aboavobr/ABOAVOBR/README.md

# ABOAVOBR - AutoBalancing Obstacle Avoiding Voice Obedient Beer Robot

| |Arduino|Raspberry Pi|App|
|:--:|:--:|:--:|:--:|
**Builds**|Build status (https://benjsawesometfstest.visualstudio.com/ABOAVOBR/_build/latest?definitionId=34)|Build status (https://benjsawesometfstest.visualstudio.com/ABOAVOBR/_build/latest?definitionId=35)|Build status (https://benjsawesometfstest.visualstudio.com/ABOAVOBR/_build/latest?definitionId=36)|
**Deployments**||||
**Release**||||

The intention of this project is to provide you with the necessary details to 3D print, assemble and program your own autobalancing robot with some quite advanced features.

## System Architecture
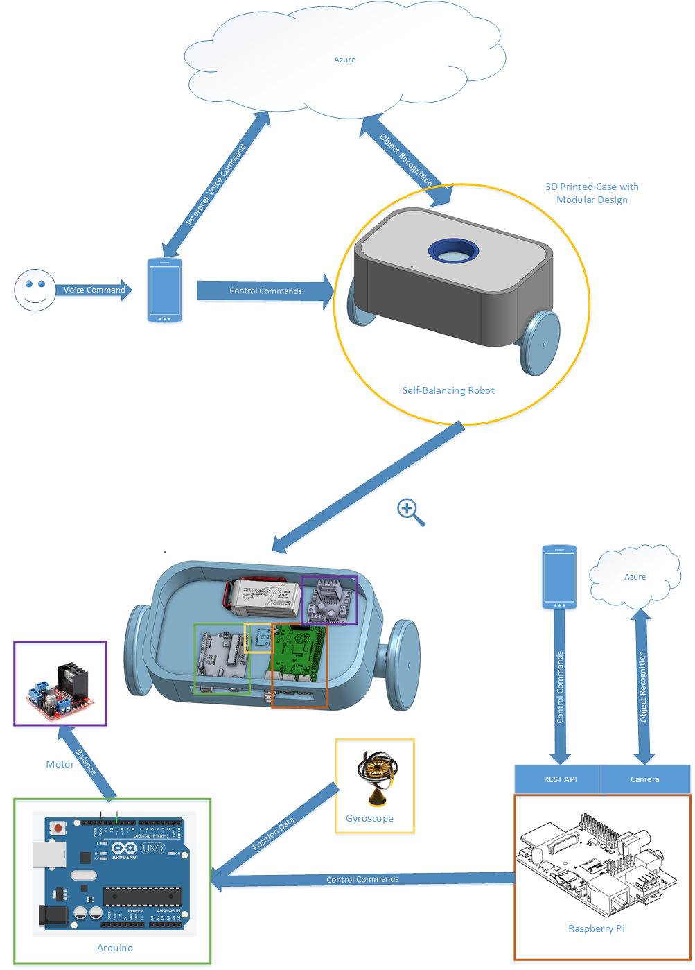
[picture p1: Documents/SystemDiagram.png]


## Bill of Materials
A detailed list with the materials needed including the 3D Model can be found [here](./Documents/BOM.md)

## Assembly instructions
TODO: Add 3d models and reference them here for printing.
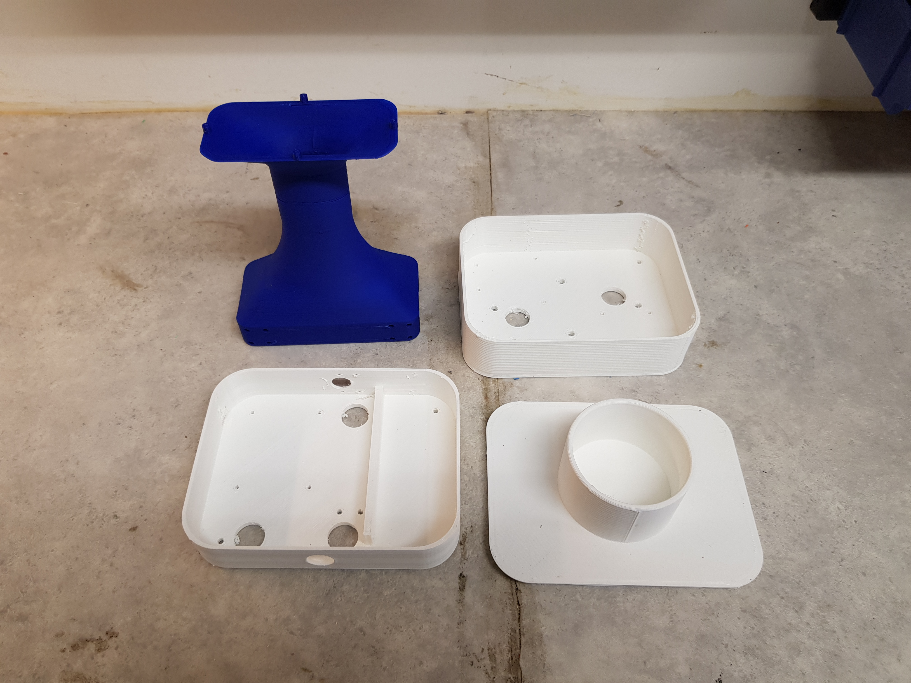
[picture p2: Construction/20190818_162025.jpg]


Fasten the motor mounts in the bottom part of the robot
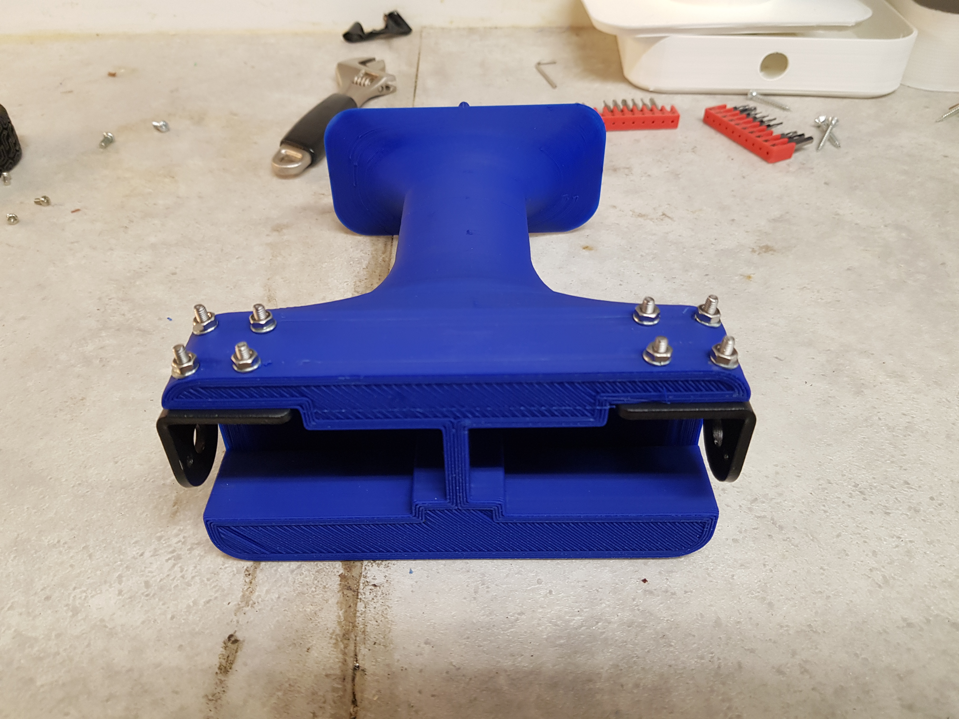
[picture p3: Construction/20190818_165857.jpg]


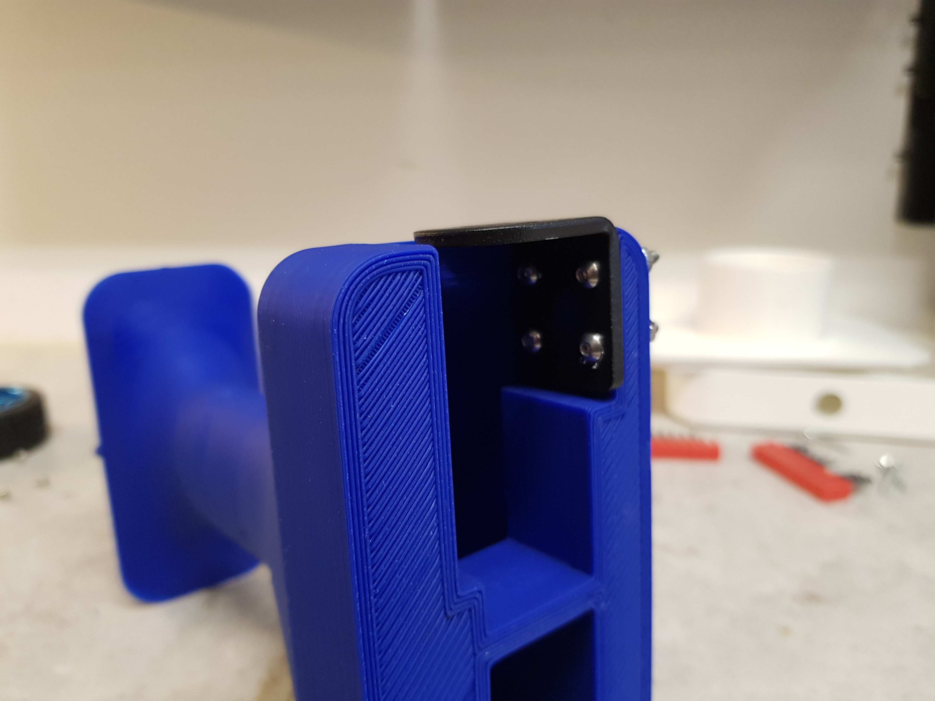
[picture p4: Construction/20190818_165904.jpg]


Lengthen the red and white wires (VCC, GND) coming out from the motors
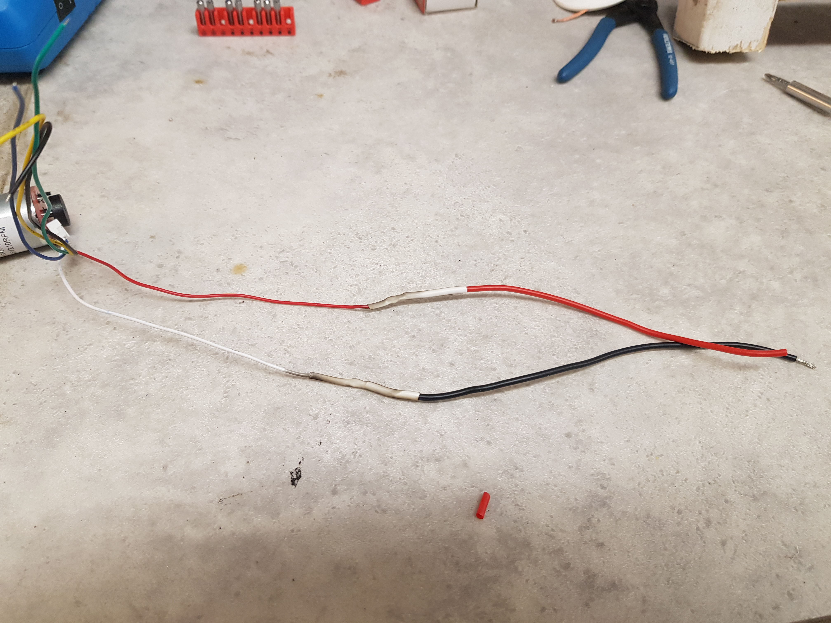
[picture p5: Construction/20190818_172829.jpg]


Mount the motors to the mounts
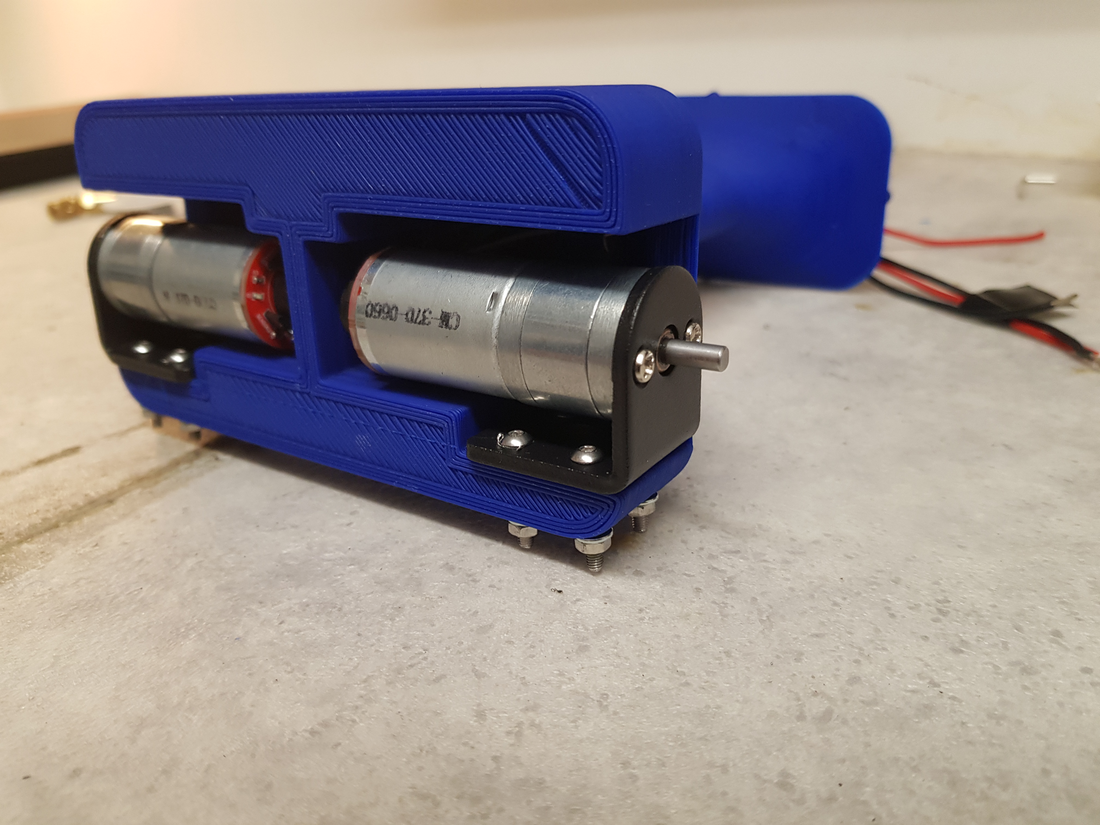
[picture p6: Construction/20190818_173135.jpg]


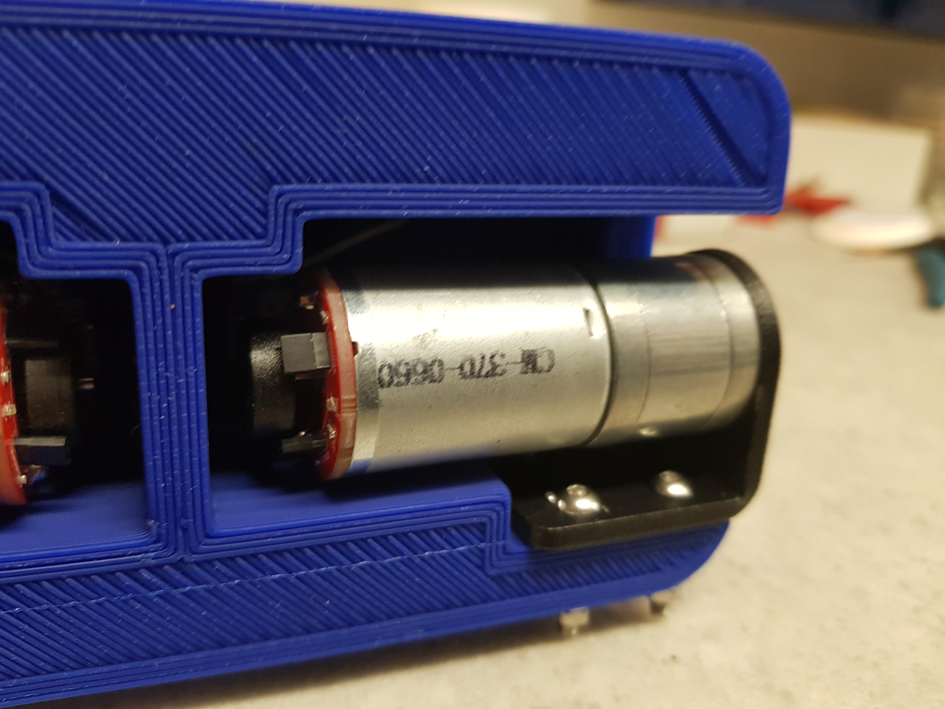
[picture p7: Construction/20190818_173138.jpg]


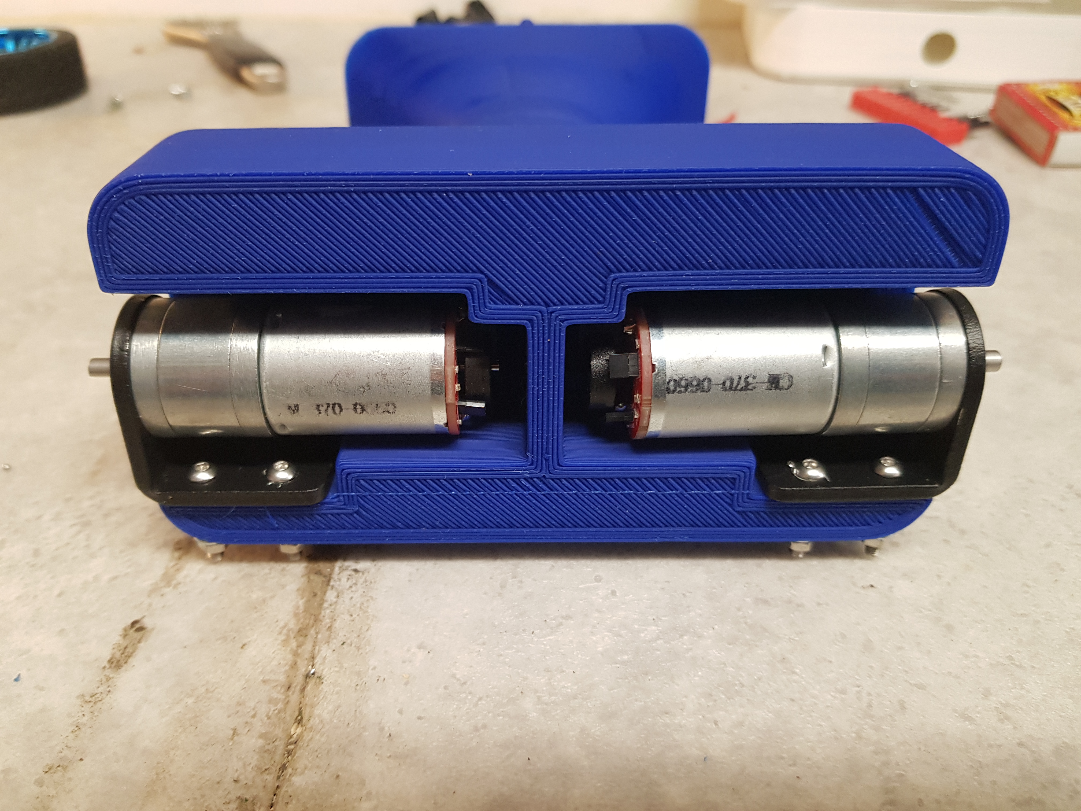
[picture p8: Construction/20190818_173141.jpg]


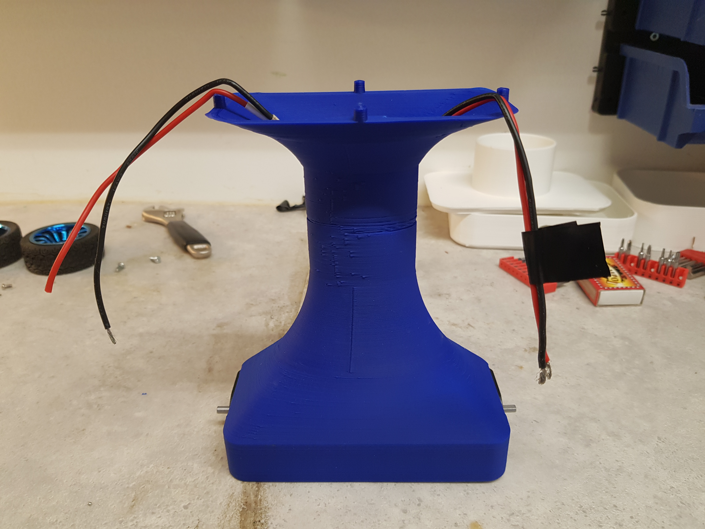
[picture p9: Construction/20190818_173156.jpg]


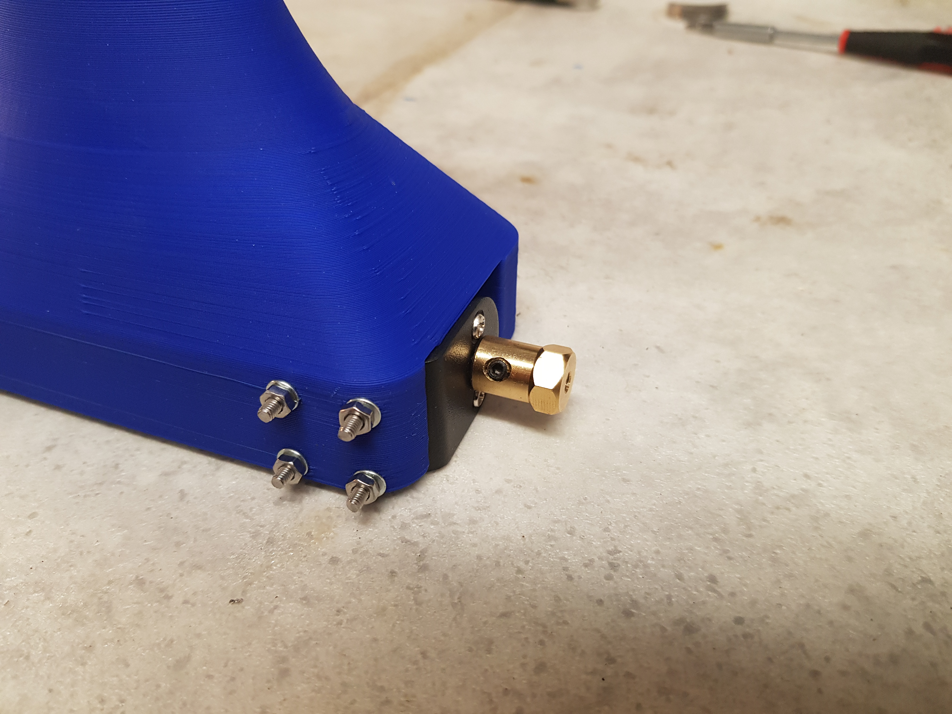
[picture p10: Construction/20190818_174238.jpg]


Mount the Arduino board in the following way to avoid putting pressure on the solder points under the board
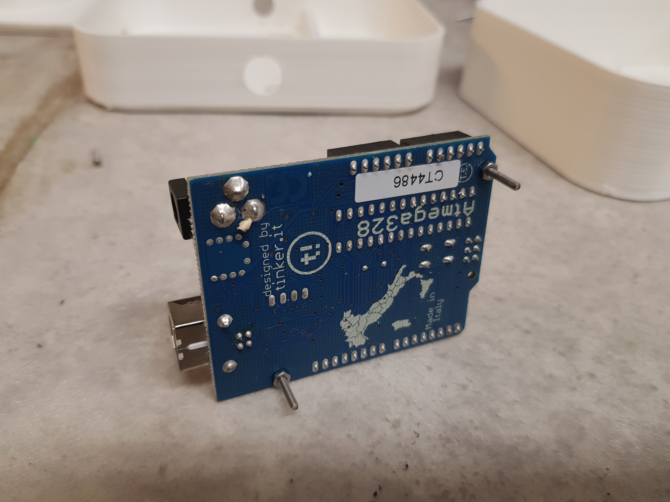
[picture p11: Construction/20190818_175032.jpg]


Mount the Arduino board in the following position
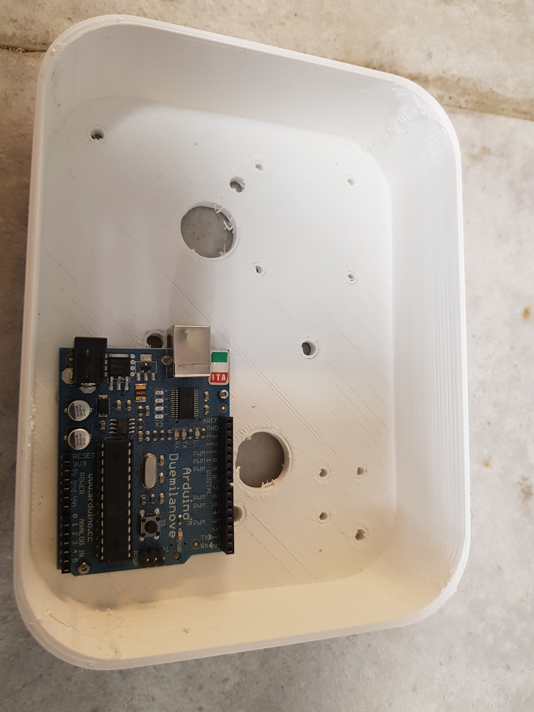
[picture p12: Construction/20190818_175536.jpg]


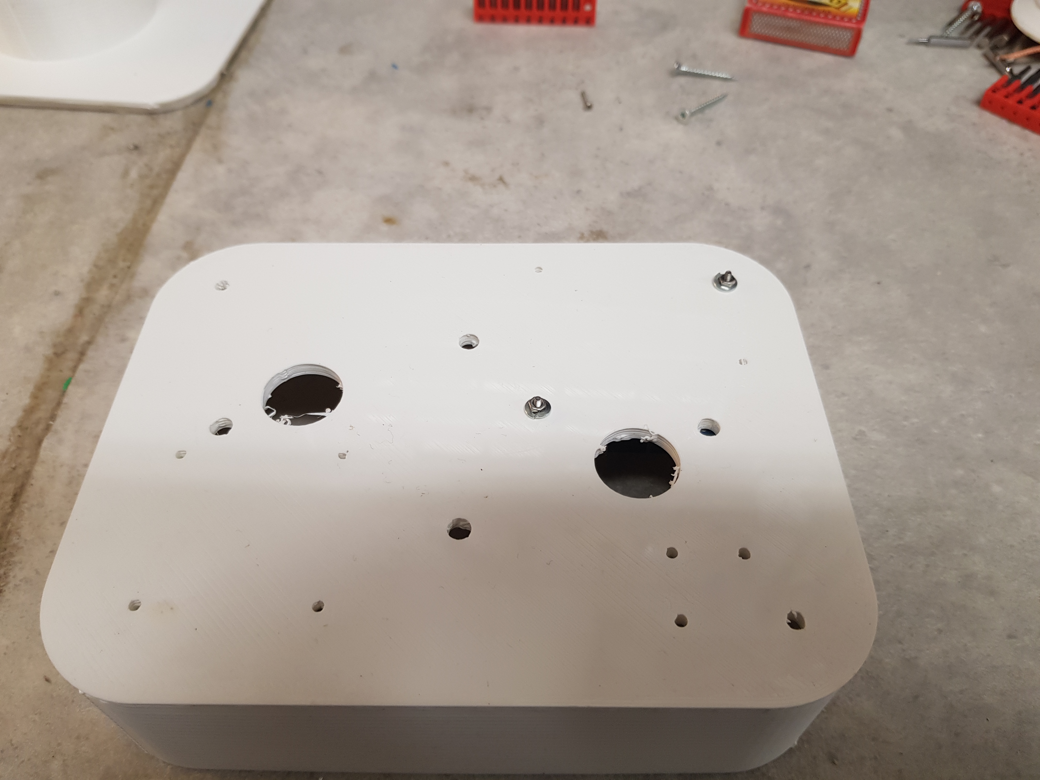
[picture p13: Construction/20190818_175544.jpg]


Solder the MPU-6050 connectors like this. Try to make it as straight as possible.
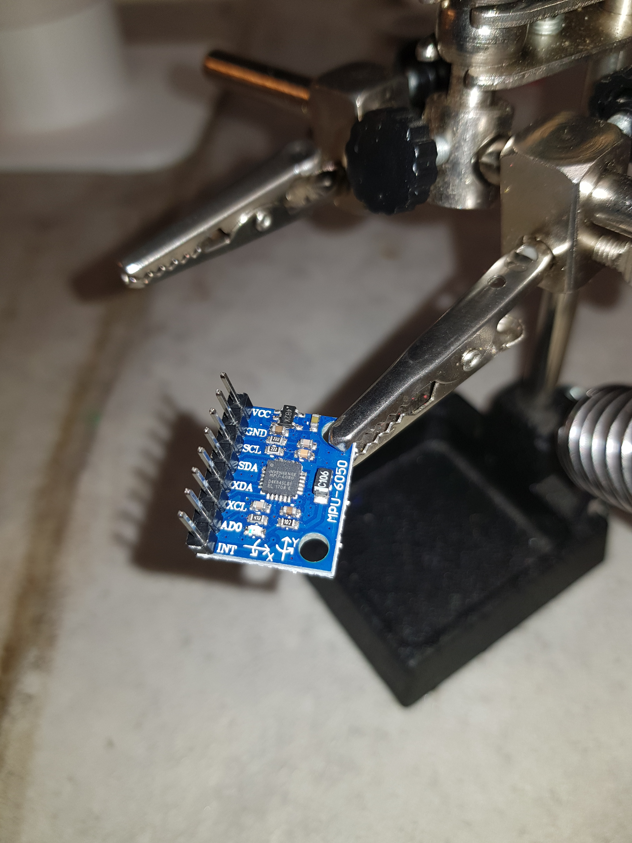
[picture p14: Construction/20190818_175742.jpg]


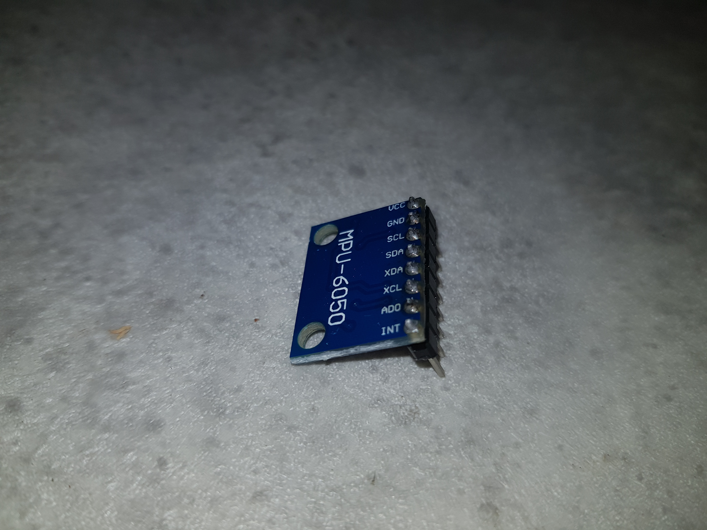
[picture p15: Construction/20190818_180144.jpg]


Mount the MPU-6050 board in a similar way to the Arduino board to avoid pressure on the solder points.
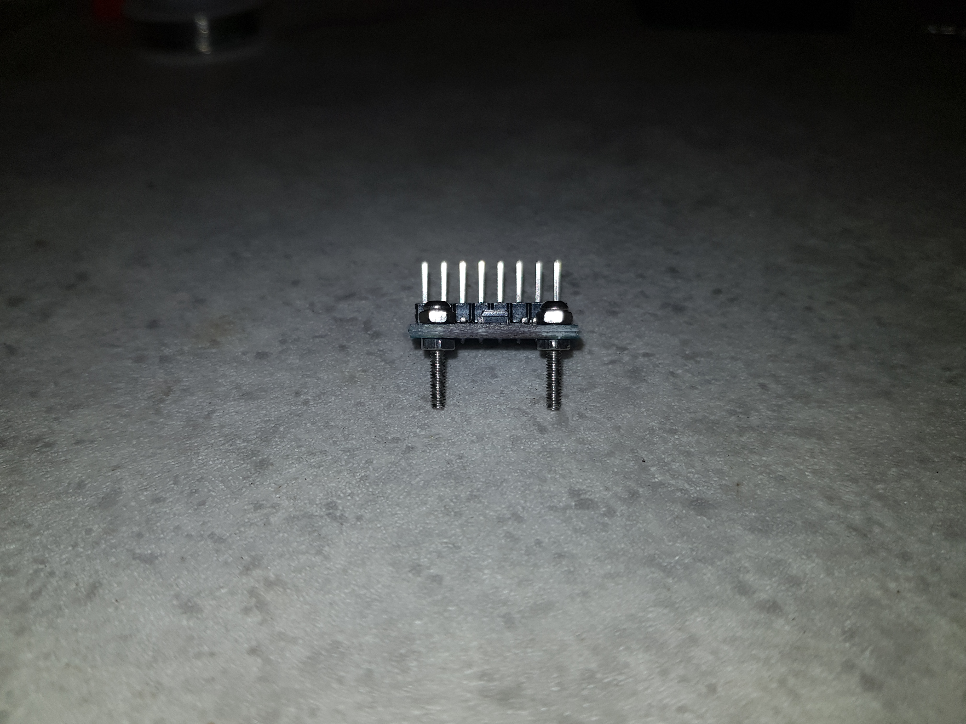
[picture p16: Construction/20190818_180807.jpg]


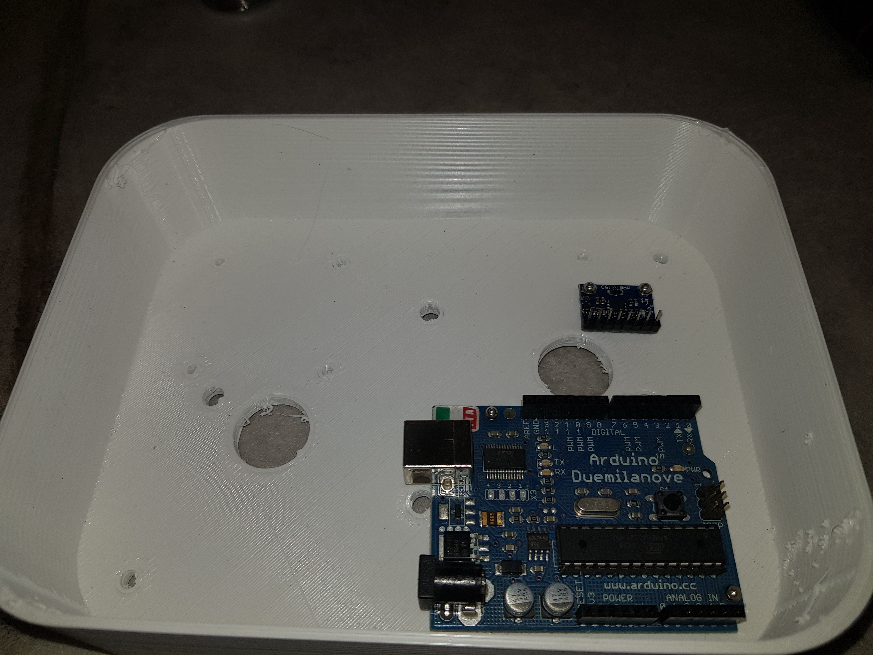
[picture p17: Construction/20190818_180953.jpg]


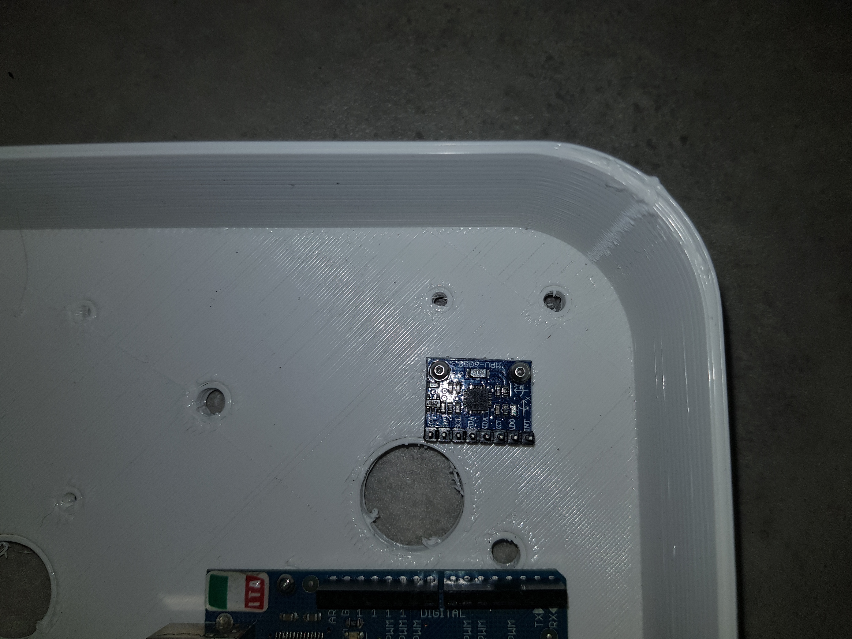
[picture p18: Construction/20190818_181000.jpg]


Mount the motor driver in a similar way.
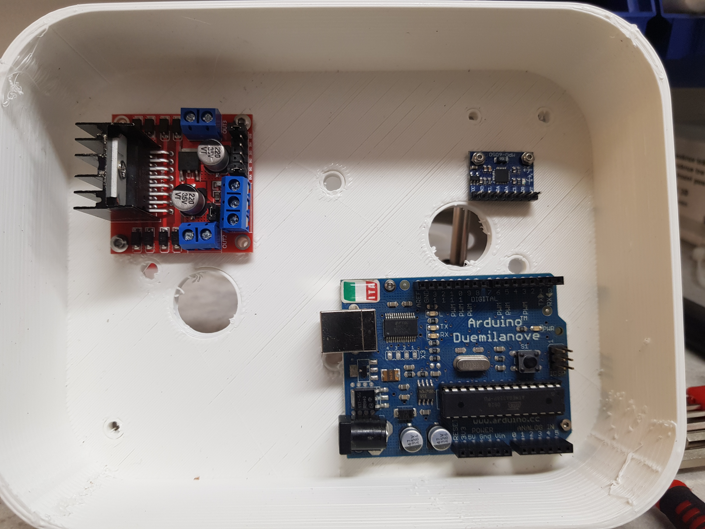
[picture p19: Construction/20190818_181622.jpg]


Mount the DC to USB converter in a similar way.
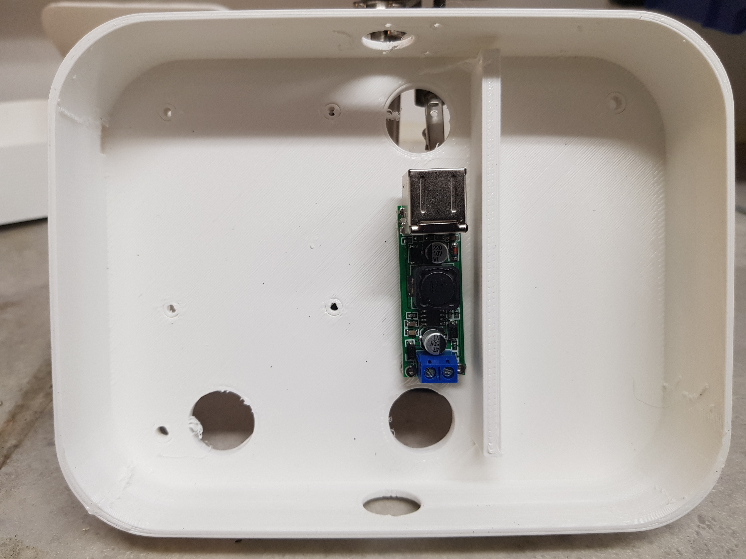
[picture p20: Construction/20190818_182159.jpg]


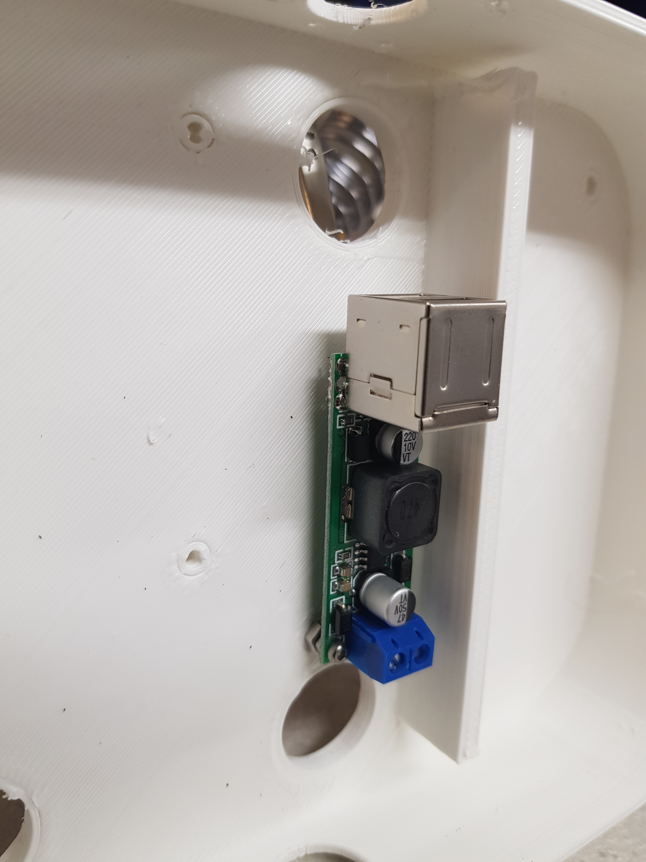
[picture p21: Construction/20190818_182206.jpg]


Mount the camera in the following way.
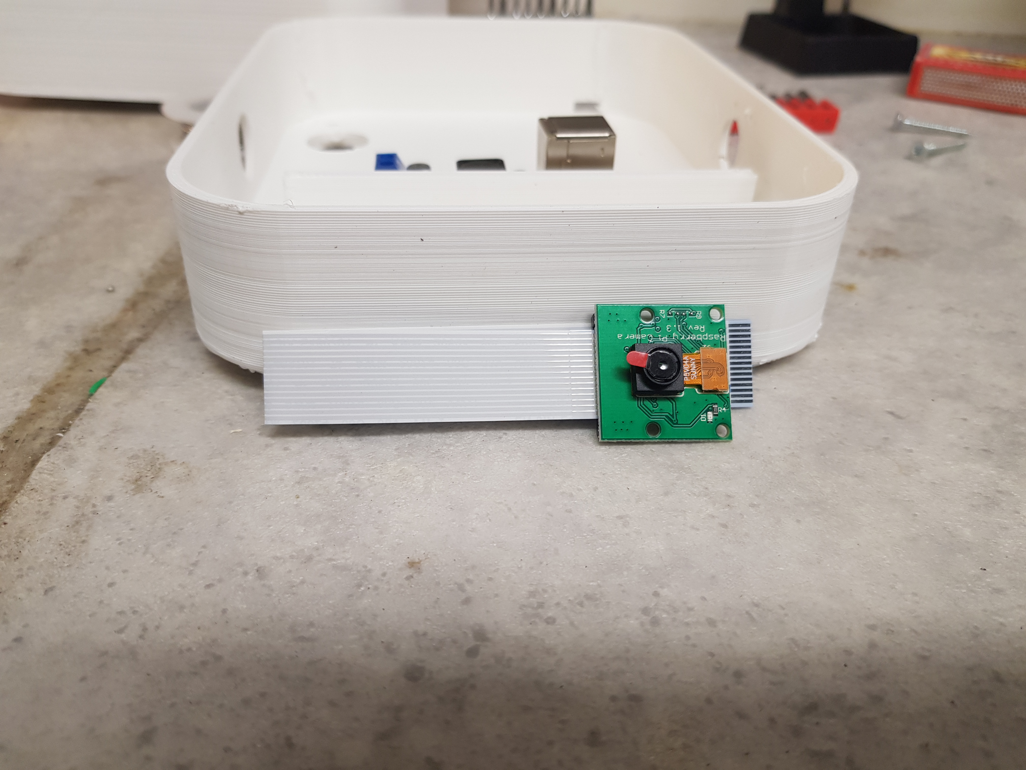
[picture p22: Construction/20190818_182832.jpg]


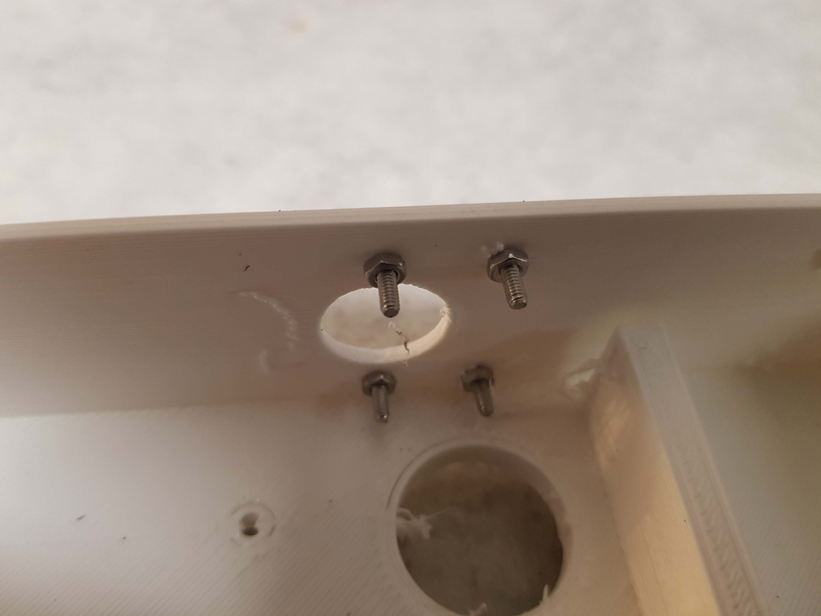
[picture p23: Construction/20190818_183507.jpg]


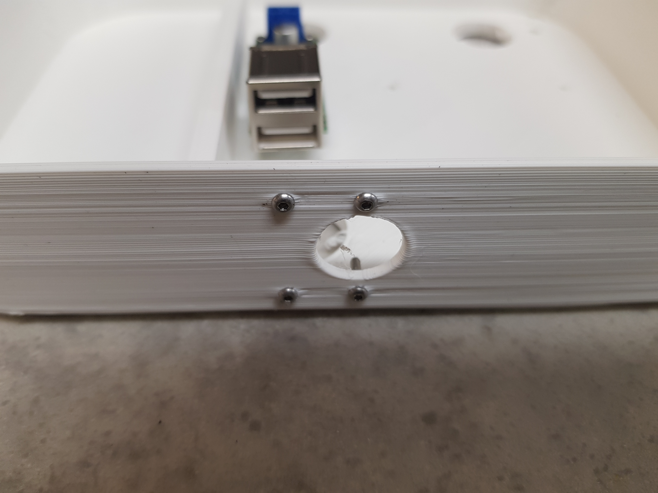
[picture p24: Construction/20190818_183520.jpg]


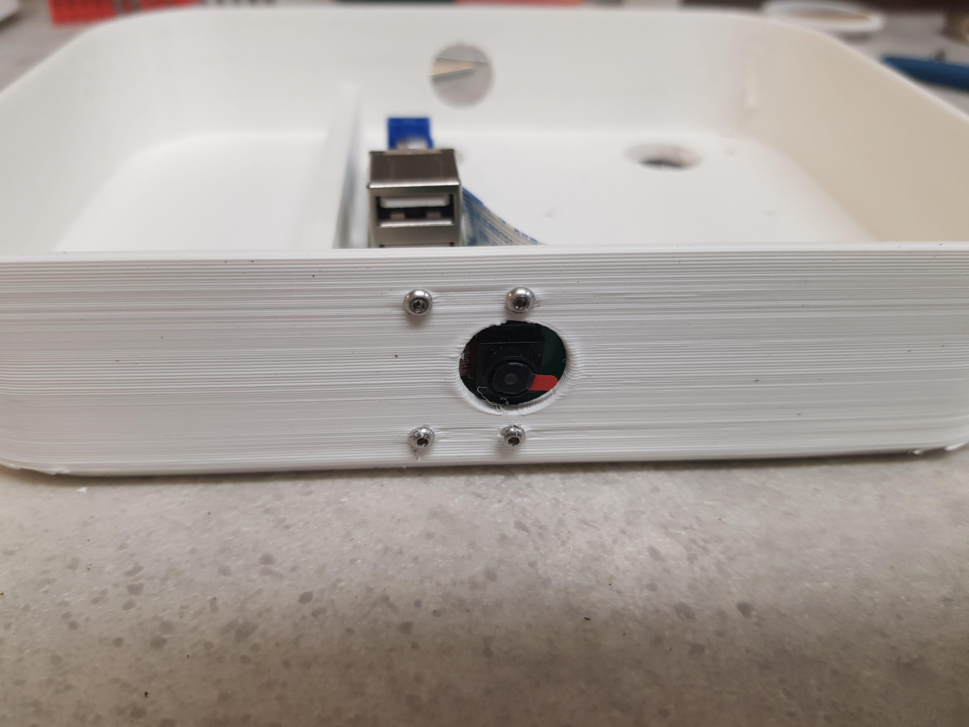
[picture p25: Construction/20190818_183907.jpg]


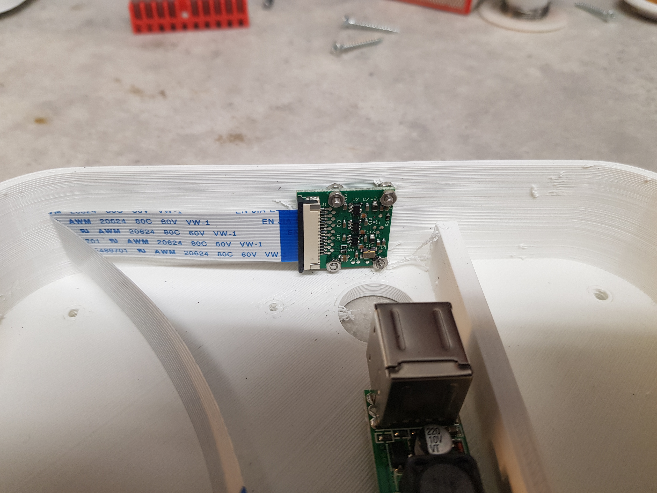
[picture p26: Construction/20190818_183912.jpg]


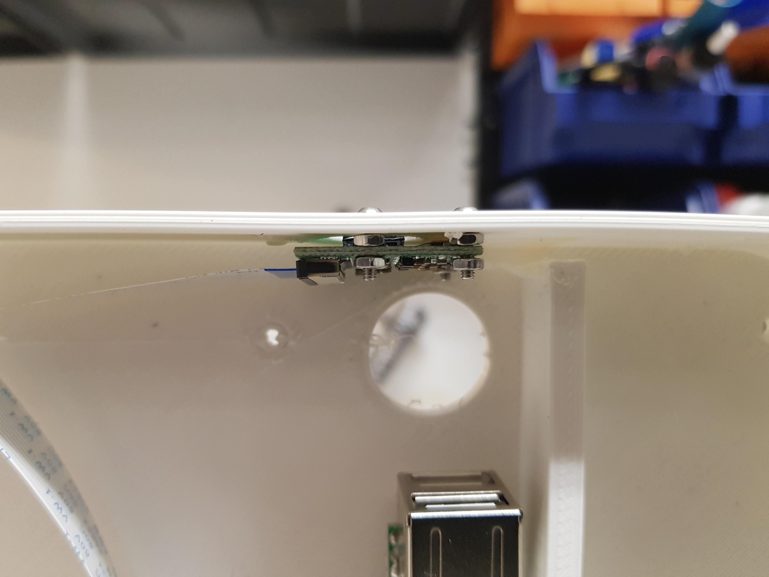
[picture p27: Construction/20190818_183920.jpg]


Mount the Raspberry in the following way.
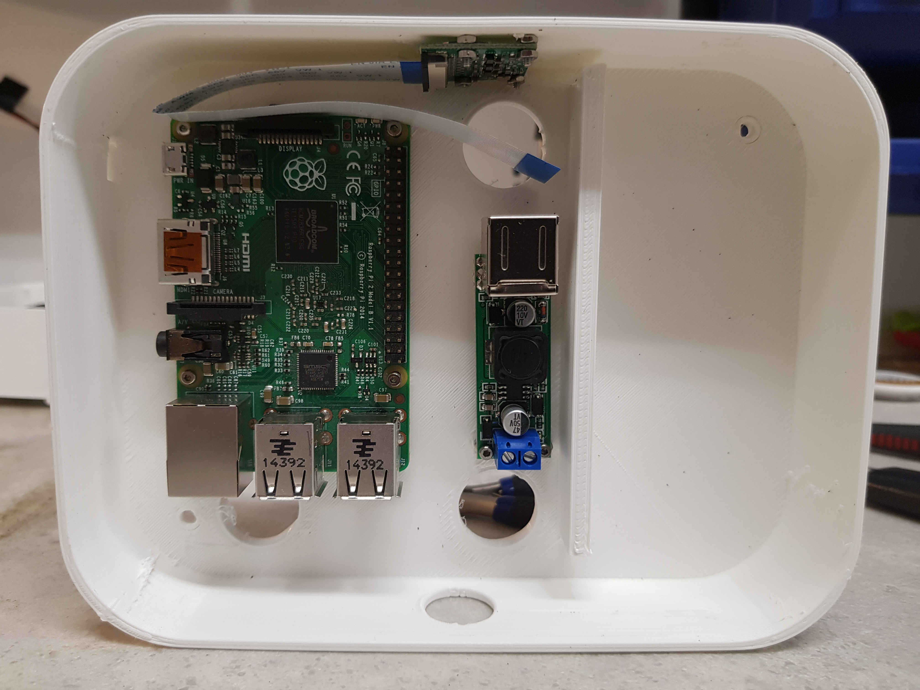
[picture p28: Construction/20190818_184743.jpg]


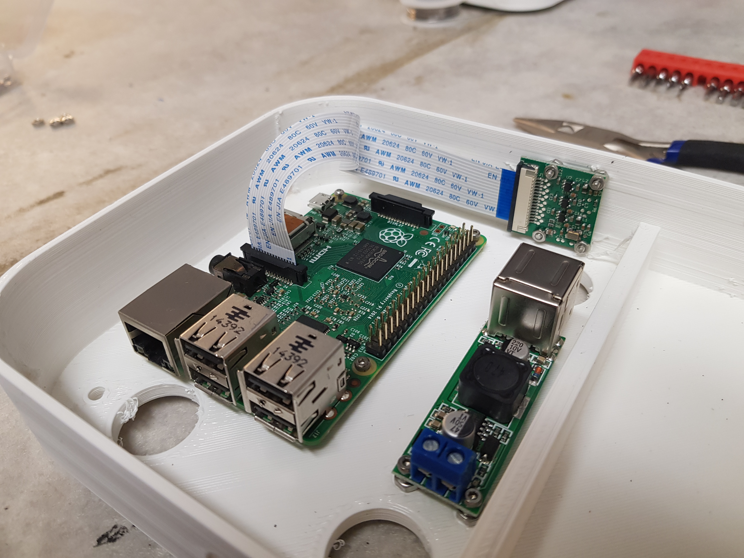
[picture p29: Construction/20190818_184845.jpg]


Mount the on/off button like this.
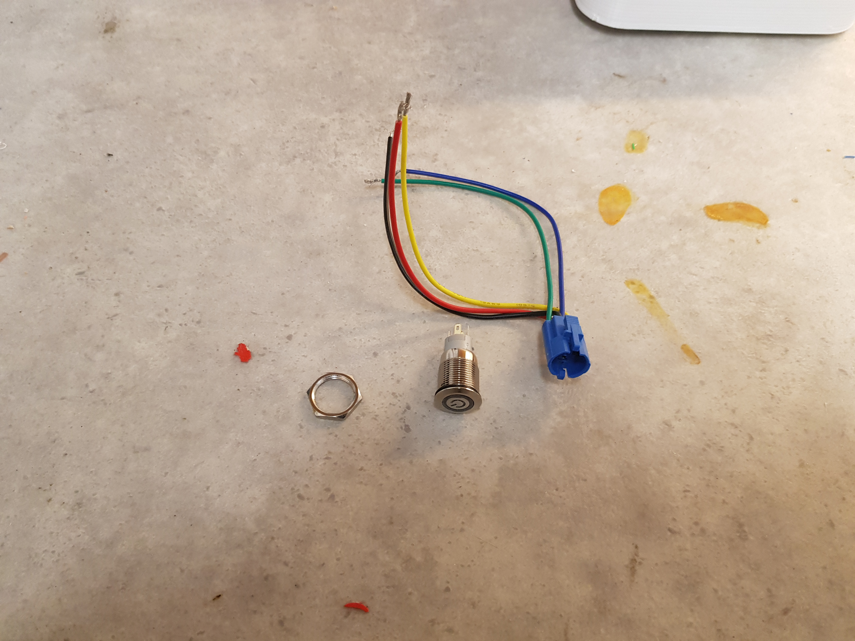
[picture p30: Construction/20191209_201055.jpg]


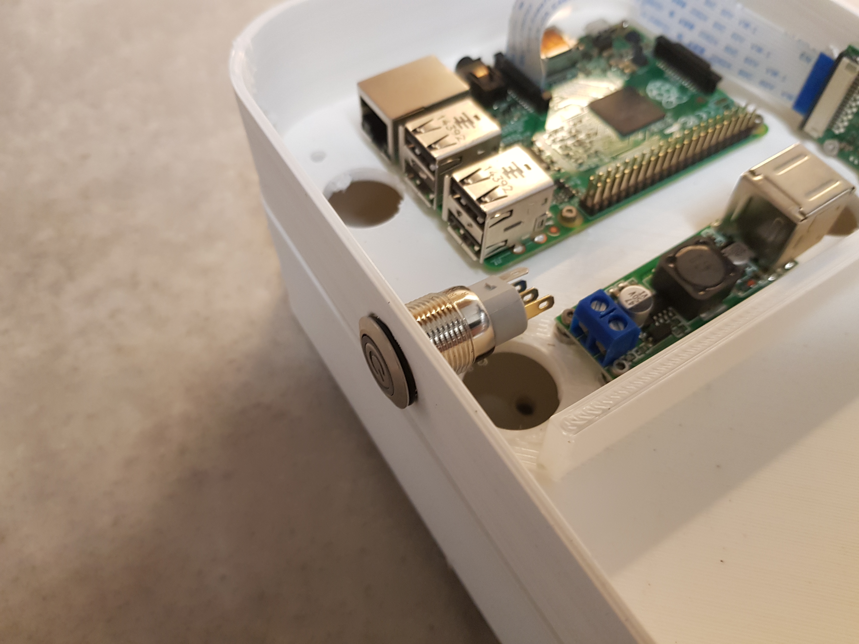
[picture p31: Construction/20191209_201214.jpg]


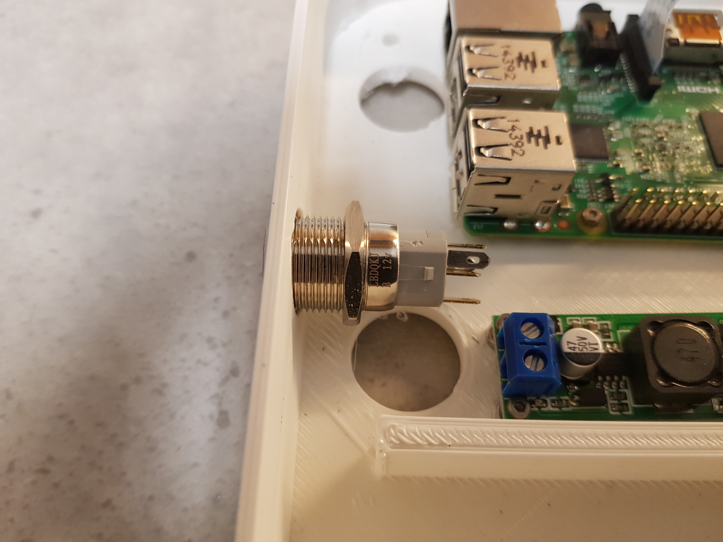
[picture p32: Construction/20191209_201232.jpg]


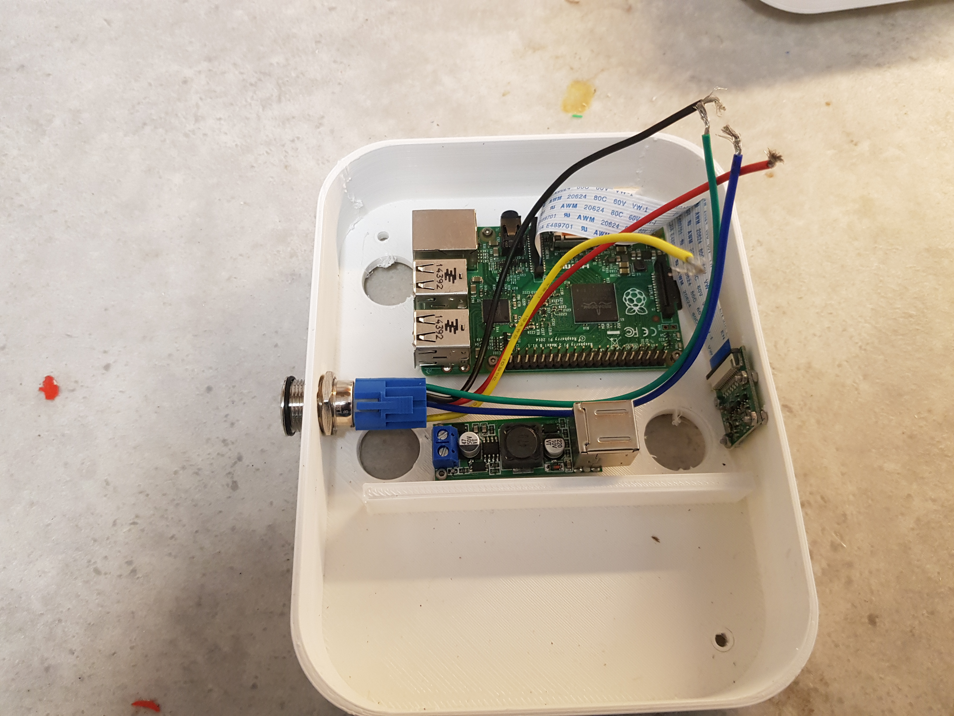
[picture p33: Construction/20191209_201254.jpg]


Isolate all wires except the blue and green ones.
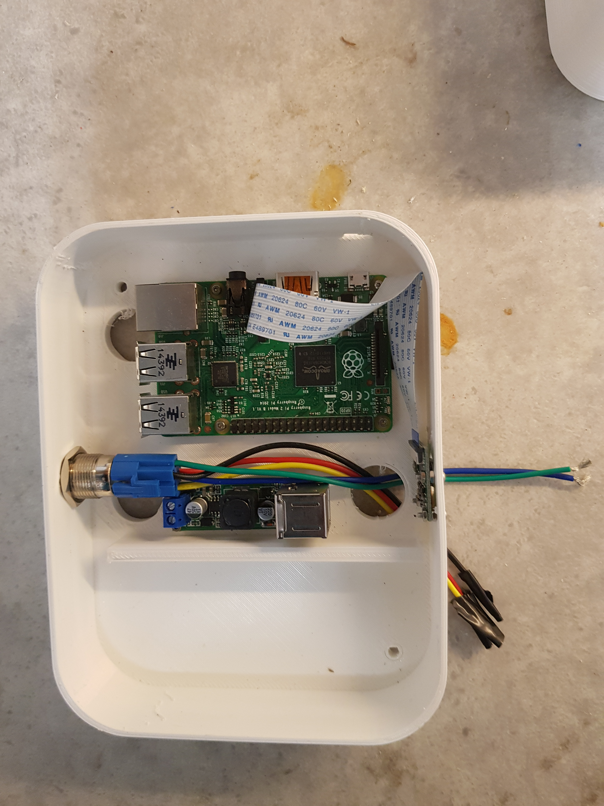
[picture p34: Construction/20191209_201535.jpg]


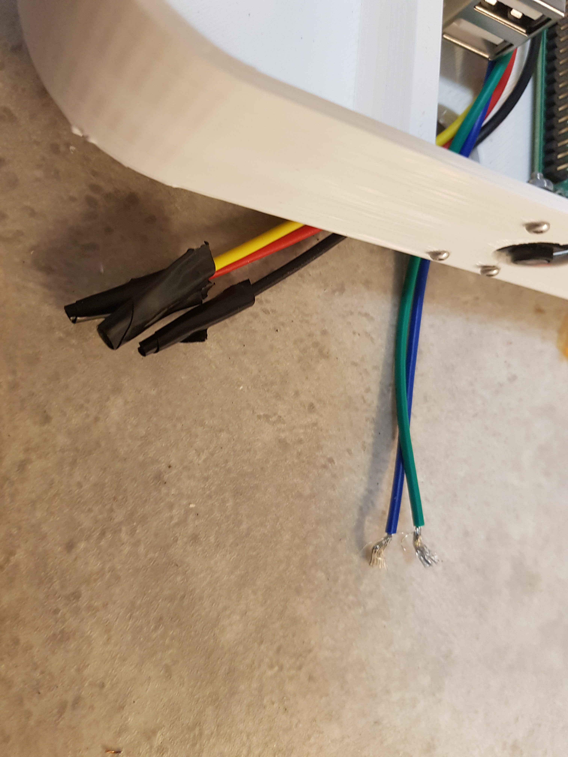
[picture p35: Construction/20191209_201538.jpg]


The main power connections are described here, but you should check the schematics at the end of the construction for a better overview.
Connect the On/Off button green wire to minus on the battery connector
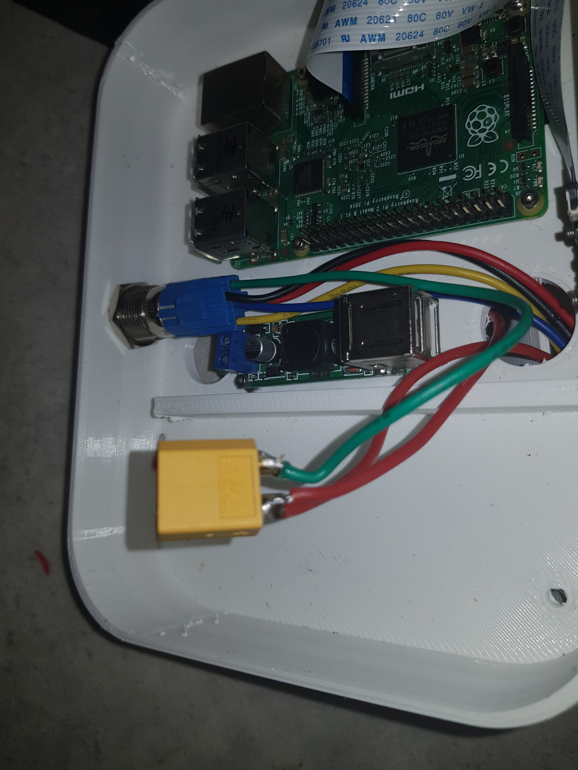
[picture p36: Construction/20191211_203137.jpg]


Connect the battery positive connector to two wires
One connected to the DC to USB converter +
One connected to the motor controller +
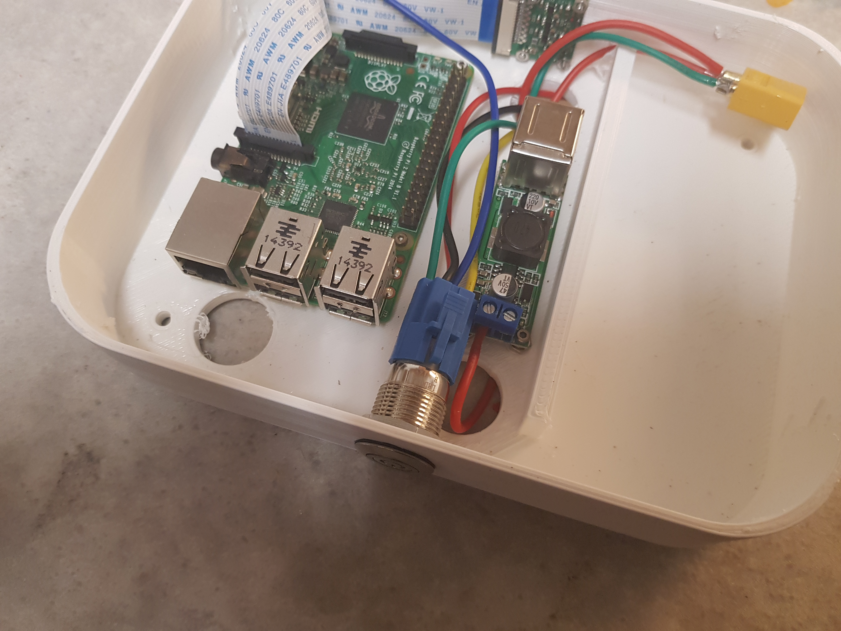
[picture p37: Construction/20191211_201144.jpg]


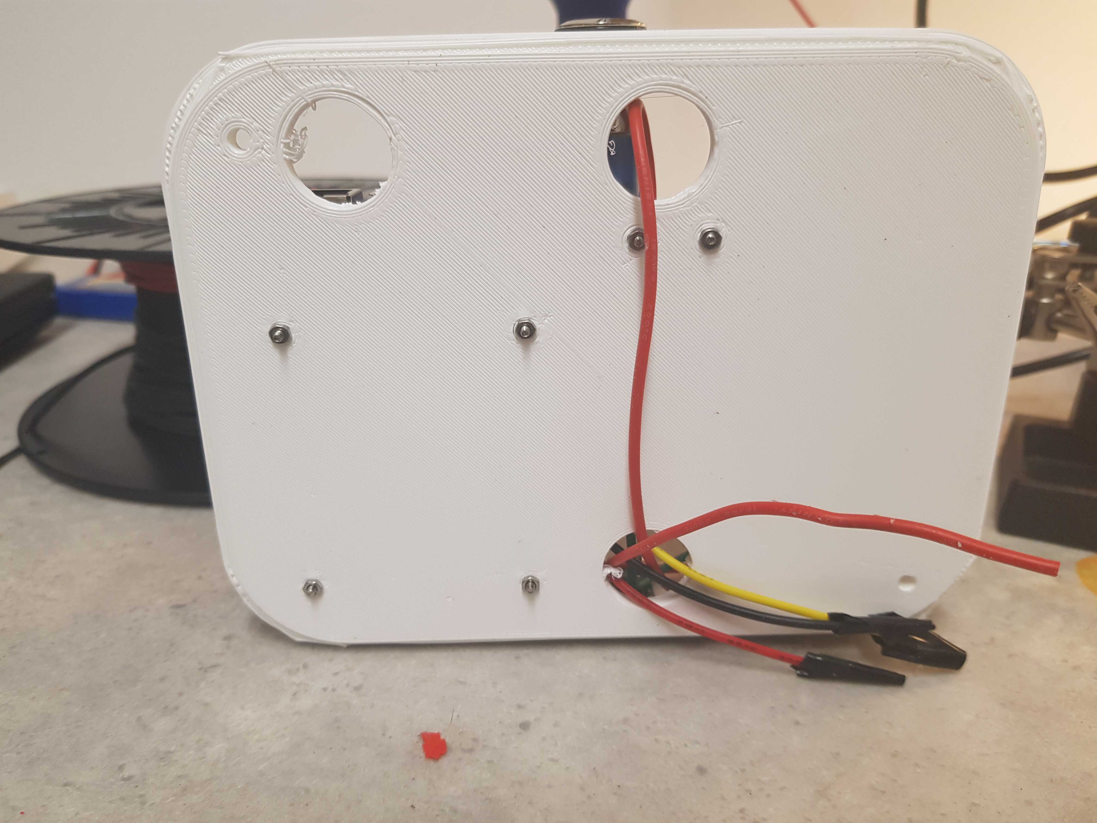
[picture p38: Construction/20191211_201149.jpg]


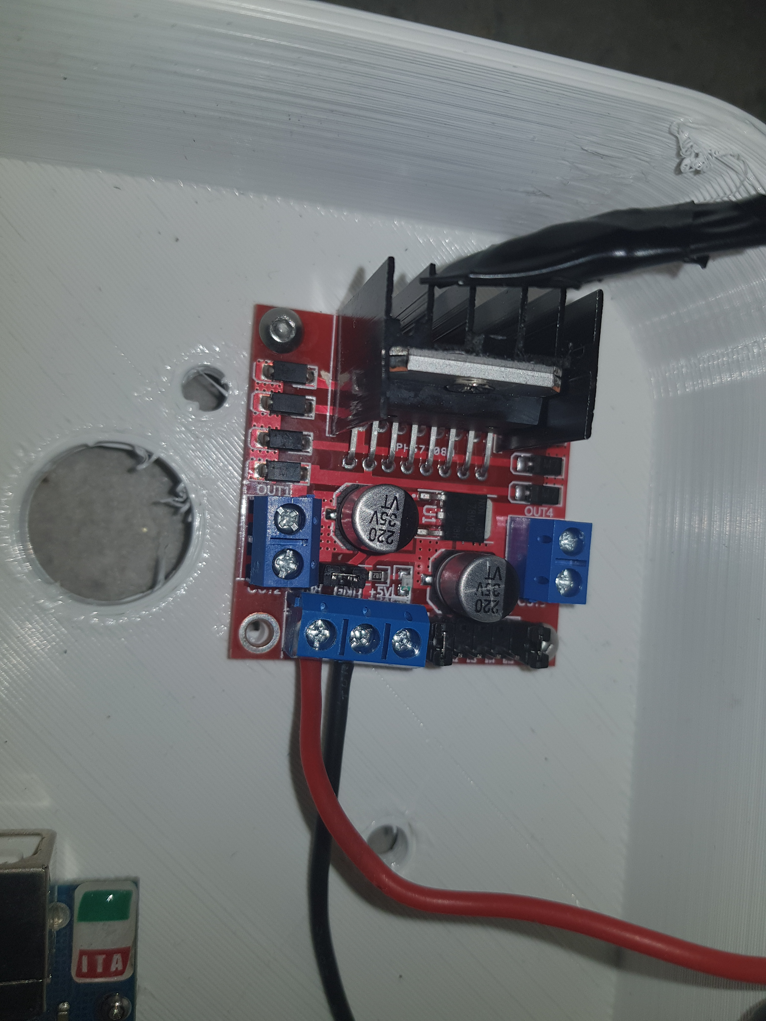
[picture p39: Construction/20191211_202011.jpg]


Connect the On/Off button blue wire to
DC to USB converter - (ground)
Motor controller - (ground)
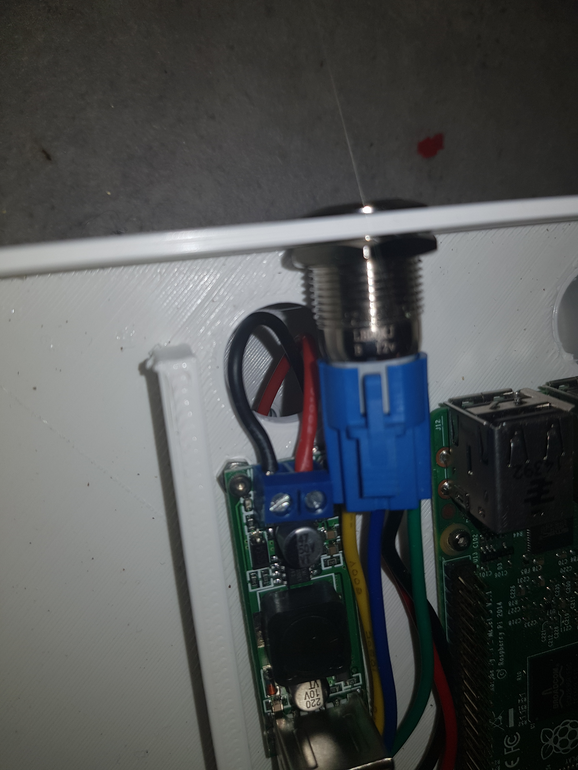
[picture p40: Construction/20191211_202135.jpg]




Connect the motors to the motor controller. You can switch the connections later if the wrong wheel is turning.
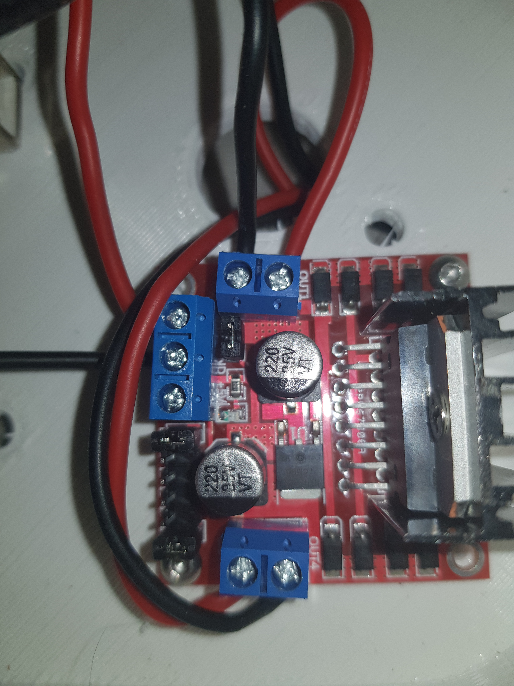
[picture p41: Construction/20191211_204043.jpg]




Connect the logic wires




Connect the Arduino to the DC to USB converter. You might have to make a frankencable to make it fit. Try to find a cable which has a very short connector as there is not much space on the converter side.

Alternatively you can connect the battery +/- directly to the voltage input of the Arduino, as it will run just fine on a 2S LIPO.
Note: This is a temporary solution. The Arduino will be powered from the Raspberry when we finalize everything.
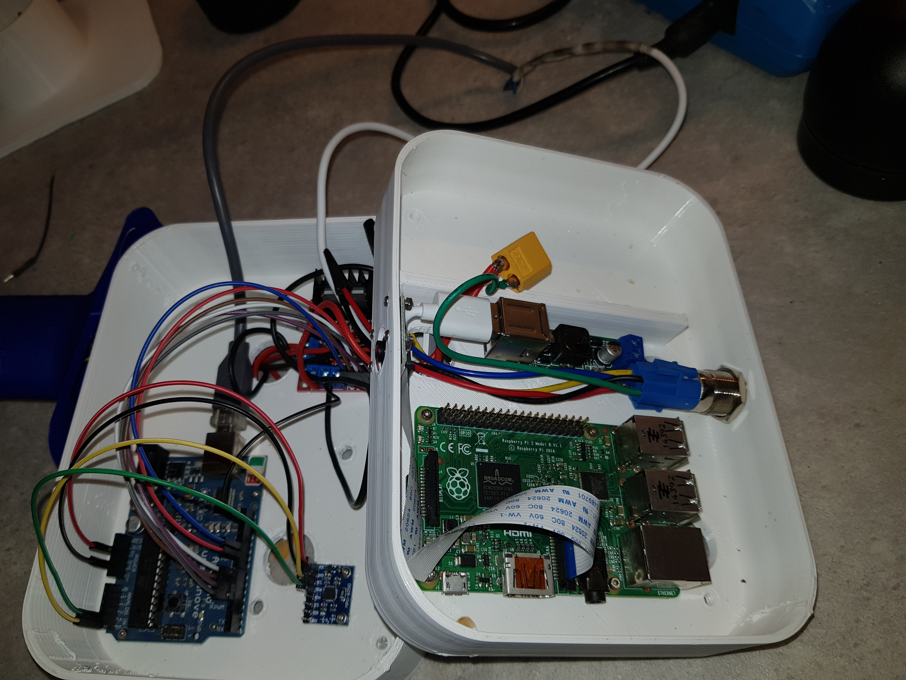
[picture p44: Construction/20191215_114205.jpg]


Schematics
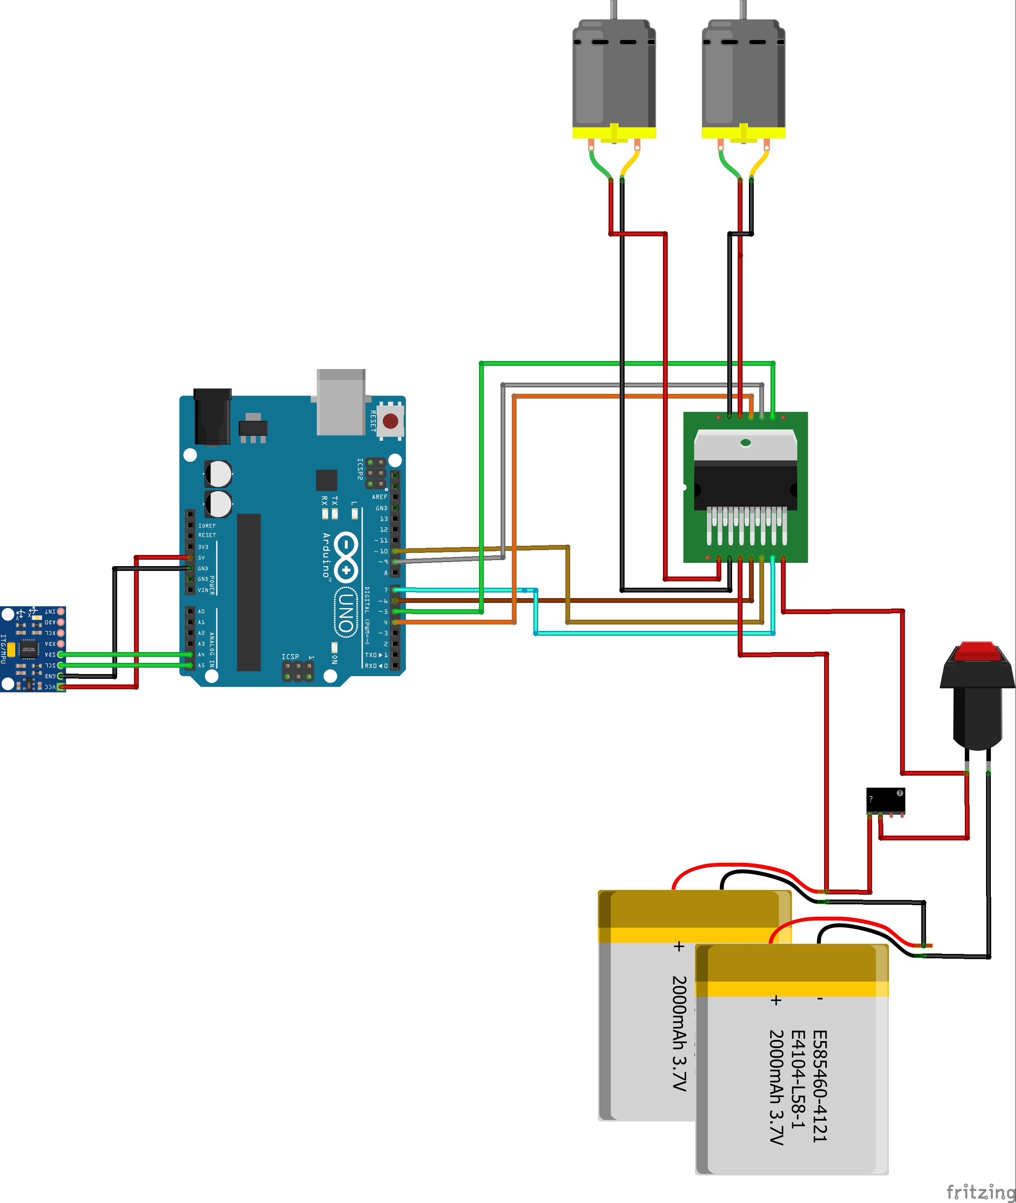
[picture p45: Construction/ABOAVOBR_schematic_bb.jpg]


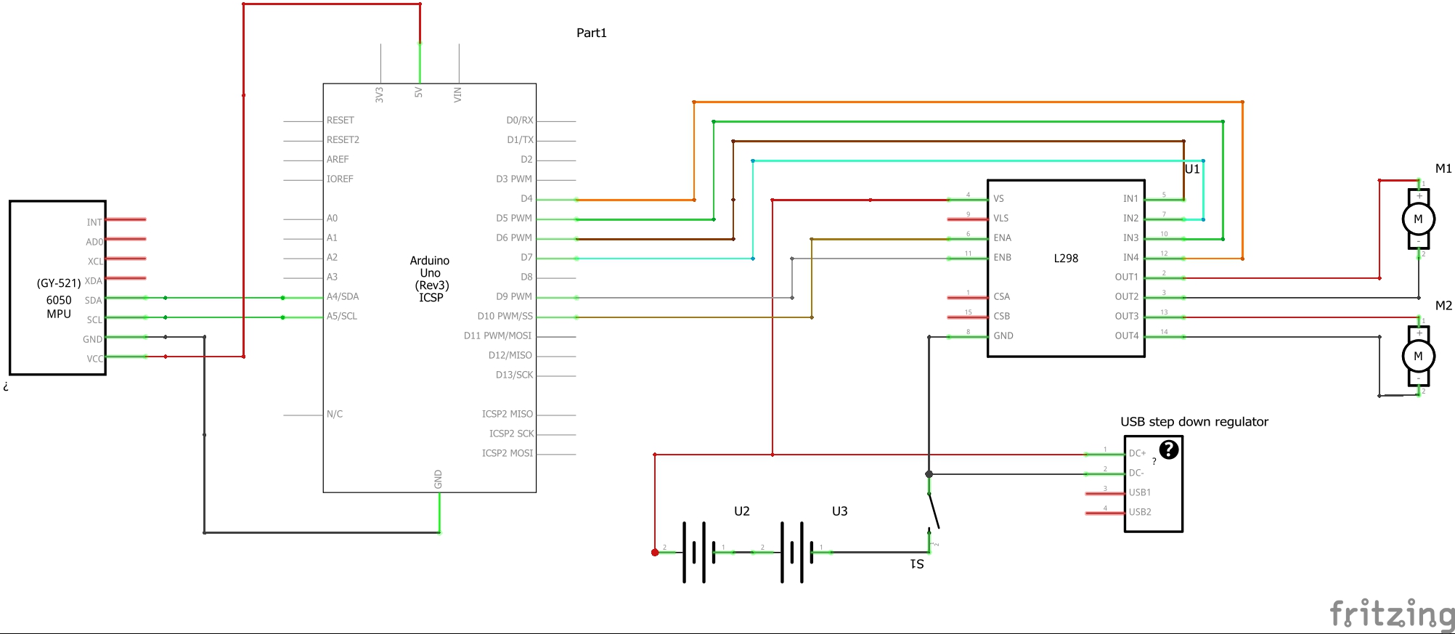
[picture p46: Construction/ABOAVOBR_schematic_schem.jpg]

TODO: Add instructions here

Starting point for collecting ideas:
https://www.instructables.com/id/Arduino-Balance-Balancing-Robot-How-to-Make/
