aboavobr/ABOAVOBR/Documents/BOM.md

# BOM - Bill Of Materials

- [Raspberry PI 3 Model B+](https://www.ebay.com/itm/2018-Raspberry-Pi-3-Model-B-Plus-1-4-GHz-64Bit-Quad-Core-WLAN-5GHz/173586132980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)
- [16GB SD Card](https://www.ebay.com/itm/32Go-64Go-128Go-Samsung-EVO-plus-Micro-SD-SDHC-SDXC-carte-memoire-CLASS-10-UHS-1/262867873846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)
- [Motors + 2 Wheels](https://www.ebay.com/itm/2X-DC-6V-210RPM-Encoder-Motor-Set-DC-Gear-Motor-with-Mounting-Bracket-and-Wheel/192432619100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)
- [Gyroscope + accelerometer](https://www.ebay.com/itm/MPU-6050-6DOF-3-Axis-Gyroscope-Accelerometer-Module-for-Arduino-DIY/201415045005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)
- [Motor driver](https://www.ebay.com/itm/L298N-Driver-Board-L298-Stepper-Motor-Drive-Controller-Module-Dual-H-Bridge/163215912088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)
- [Raspberry PI camera](https://www.ebay.com/itm/for-Raspberry-Pi-3-Pi-2-Camera-Module-Board-5MP-Webcam-Video-1080p-720p-Mode/263893262557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)
- [Stereo speaker driver - Pricey, find alternative?](https://www.ebay.com/itm/Adafruit-I2S-3W-Stereo-Speaker-Bonnet-for-Raspberry-Pi-ADA3346/332322797099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)
- [2x 40mm*20mm 4Ohm 3W Full Range Audio Speaker Stereo Woofer Loudspeaker PU](https://www.ebay.com/itm/1-2-5Pcs-40mm-20mm-4Ohm-3W-Full-Range-Audio-Speaker-Stereo-Woofer-Loudspeaker-PU/332393413331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)
- [5V USB converter](https://www.ebay.com/itm/DIY-DC-6-35V-to-5V-3A-Double-USB-Converter-Voltage-Step-Down-Regulator-Module/271700574802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)
- [Arduino Uno](https://www.ebay.com/itm/UNO-R3-REV3-ATmega328-16U2-100-Compatible-Arduino-ULTIMA-VERSION-CABLE-INCLUIDO/251988165728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)
- [Arduino prototype shield board](https://www.ebay.com/itm/New-Prototyping-Prototype-Shield-ProtoShield-Mini-Breadboard-for-Arduino-UNO/232465486889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)
- [On/Off button](https://www.ebay.com/itm/1Pc-Metal-ON-OFF-Switch-16-12mm-12V-Car-LED-Power-Momentary-Push-Button-Durable/113306483006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)

## More General Parts
- [Black power cable 18AWG](https://hobbyking.com/en_us/turnigy-18awg-siliconewire-black-10m.html)
- [Red power cable 18 AWG](https://hobbyking.com/en_us/turnigy-high-quality-18awg-silicone-wire-10m-red.html)
- [LiPo charger](https://www.ebay.com/itm/IMAX-B6-LCD-Screen-Digital-RC-Balance-Charger-for-Lipo-NiMh-Battery-Adapter-CO/302546132210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)
- [XT-60 charger cable](https://www.ebay.com/itm/15cm-XT-60-To-4-0-Banana-Plug-Balance-Charge-Cable-For-Rc-Helicopter-TS/172163733142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)
- [2S battery signal extension cable](https://www.ebay.com/itm/2S-3S-4S-5S-6S-Balancer-JST-XH-Verlangerungskabel-Ladekabel-Lipo-Akku-20cm-24AWG/192145568088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)
- [7.4V 2200mah LiPo battery. This battery should provide about an hour of fun.](https://hobbyking.com/en_us/zippy-flightmax-2200mah-2s1p-20c.html)
- [Super glue for PLC](https://www.ebay.com/itm/2pcs-502-SUPER-GLUE-CYANOACRYLATE-ADHESIVE-PLC/223221375971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)
- [Dupont cables](https://www.ebay.com/itm/40-Pcs-Dupont-M-F-M-M-F-F-Cables-Jumper-Breadboard-Wire-GPIO-Ribbon-Pi-Arduino/152953441696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)

## 3D Model
This is the open source 3D model for the robot design. You will need to 3D print these parts and glue them together. The model can be found on [OnShape](
https://cad.onshape.com/documents/123f6eefae799bc4a059b332/w/fbc0801ffc9ca431e21d0619/e/835a318b4cb1a3c7ccbc66cf)  
**TODO: Add information on printing and building this model.**

## Battery tester
Build a battery tester for Arduino. This will be needed to keep track of the LiPo charge, to make sure we do not go below acceptable levels.
[https://pimylifeup.com/arduino-battery-tester](https://pimylifeup.com/arduino-battery-tester/)
