aboavobr/ABOAVOBR/Construction/20190818_162142.jpg

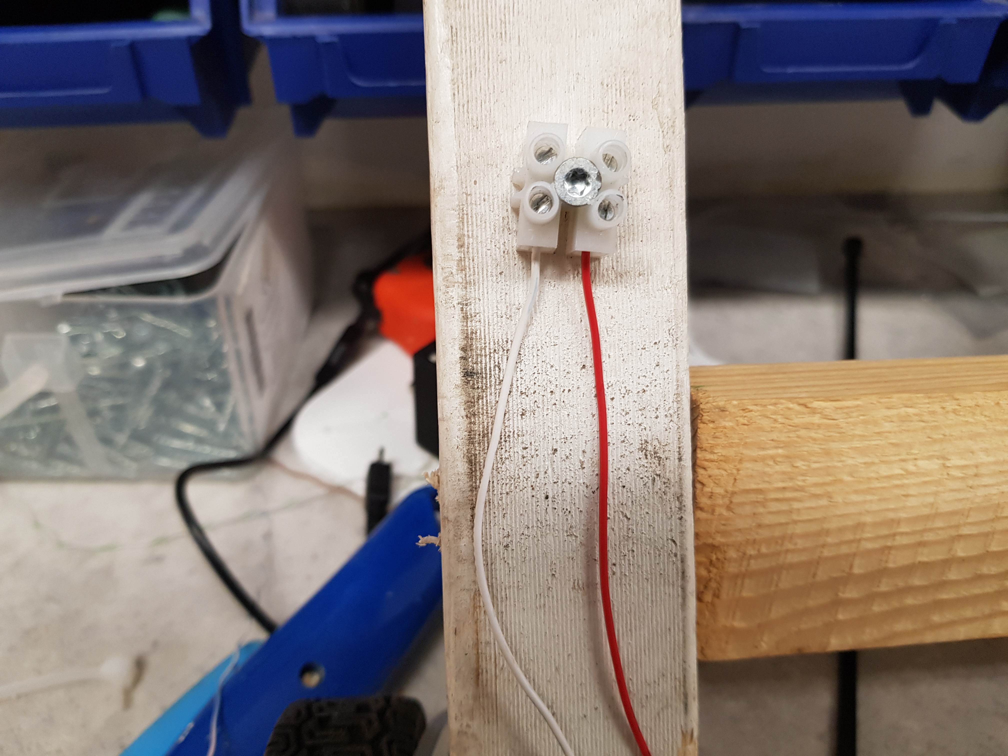
Construction/20190818_162142.jpg
