aboavobr/ABOAVOBR/Construction/20190818_165910.jpg

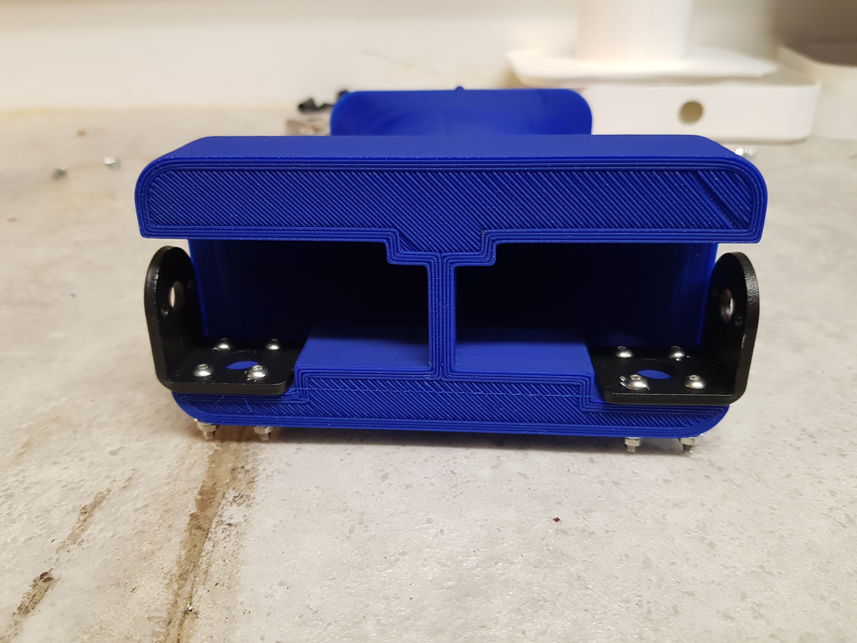
Construction/20190818_165910.jpg
