aboavobr/ABOAVOBR/Construction/20190818_174250.jpg

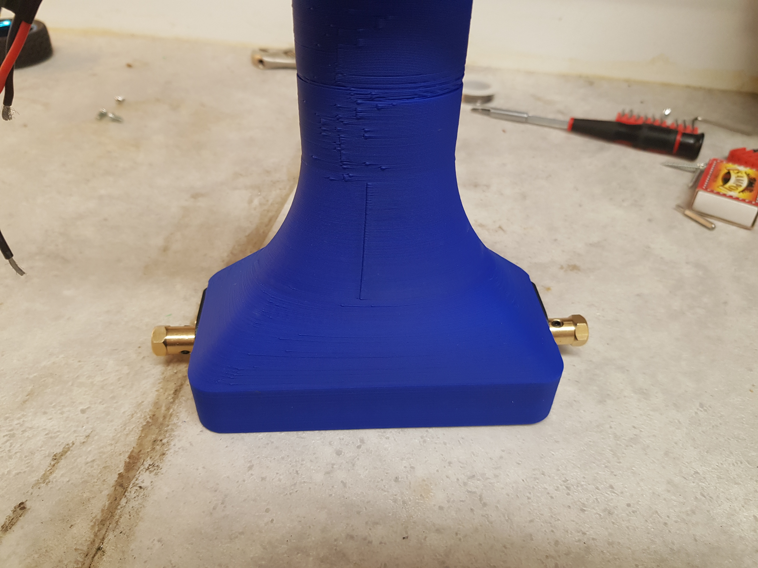
Construction/20190818_174250.jpg
