aboavobr/ABOAVOBR/Construction/20190818_180815.jpg

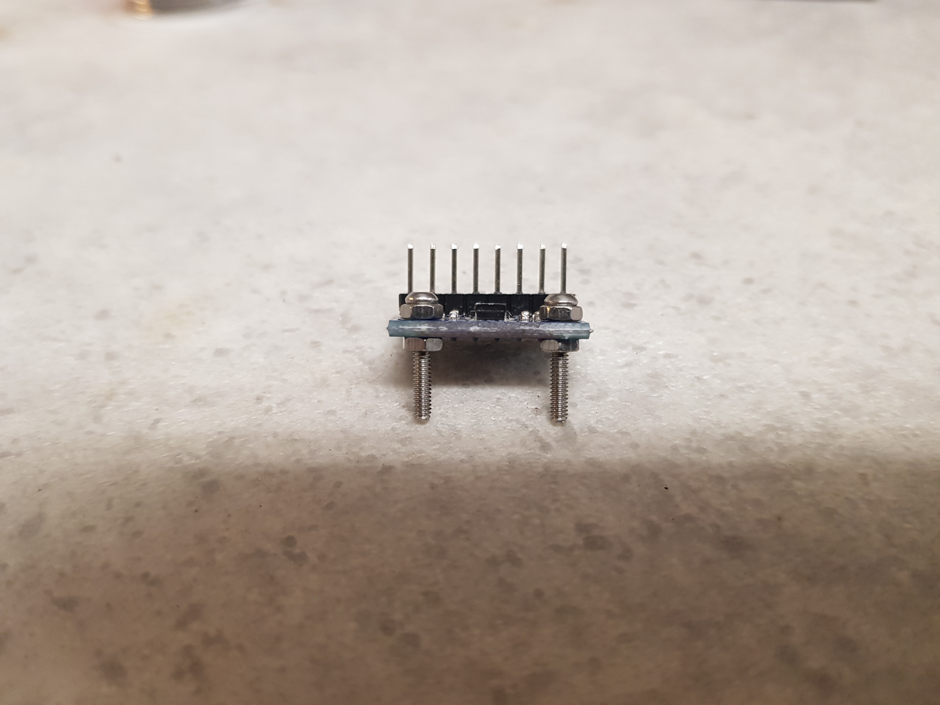
Construction/20190818_180815.jpg
