aboavobr/ABOAVOBR/Construction/20190818_181618.jpg

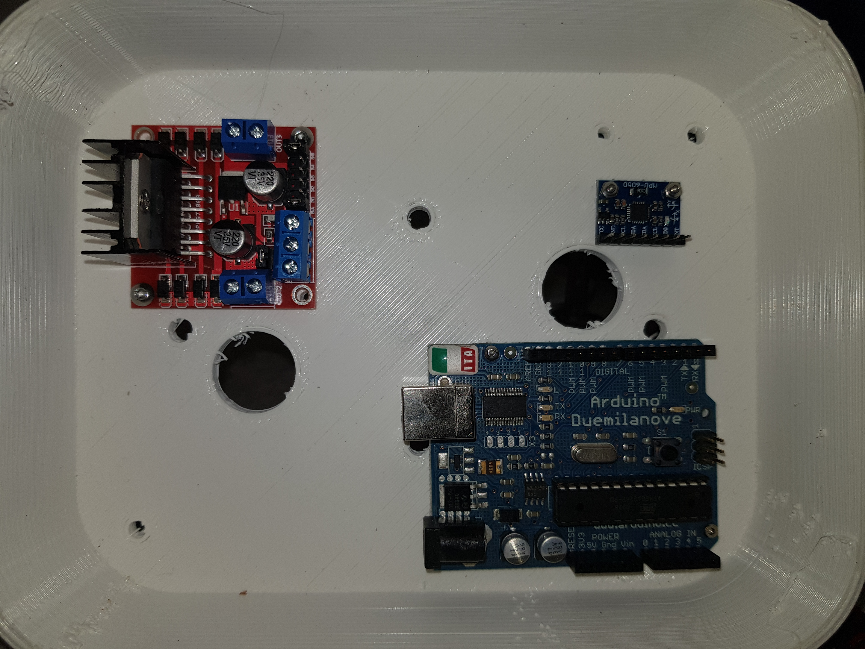
Construction/20190818_181618.jpg
