aboavobr/ABOAVOBR/Construction/20190818_183522.jpg

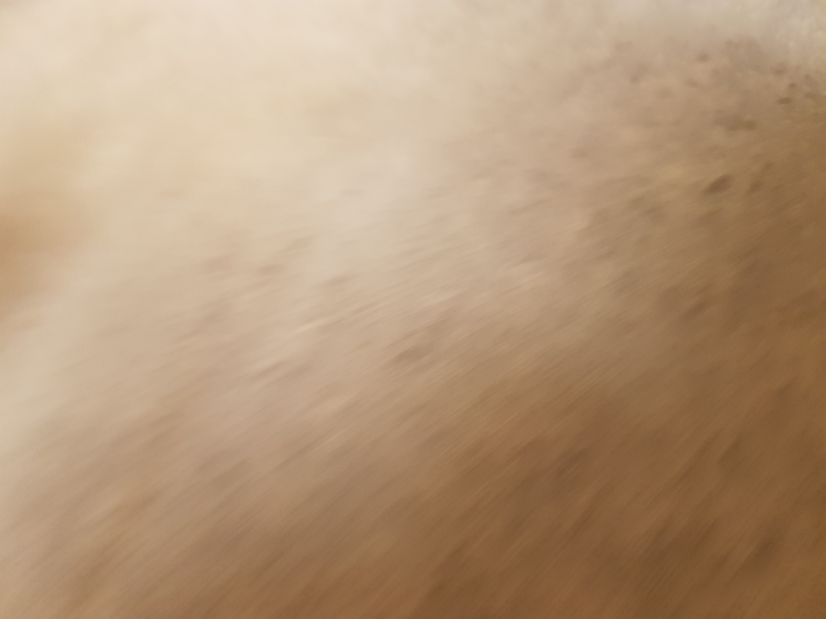
Construction/20190818_183522.jpg
