aboavobr/ABOAVOBR/Construction/20190818_185132.jpg

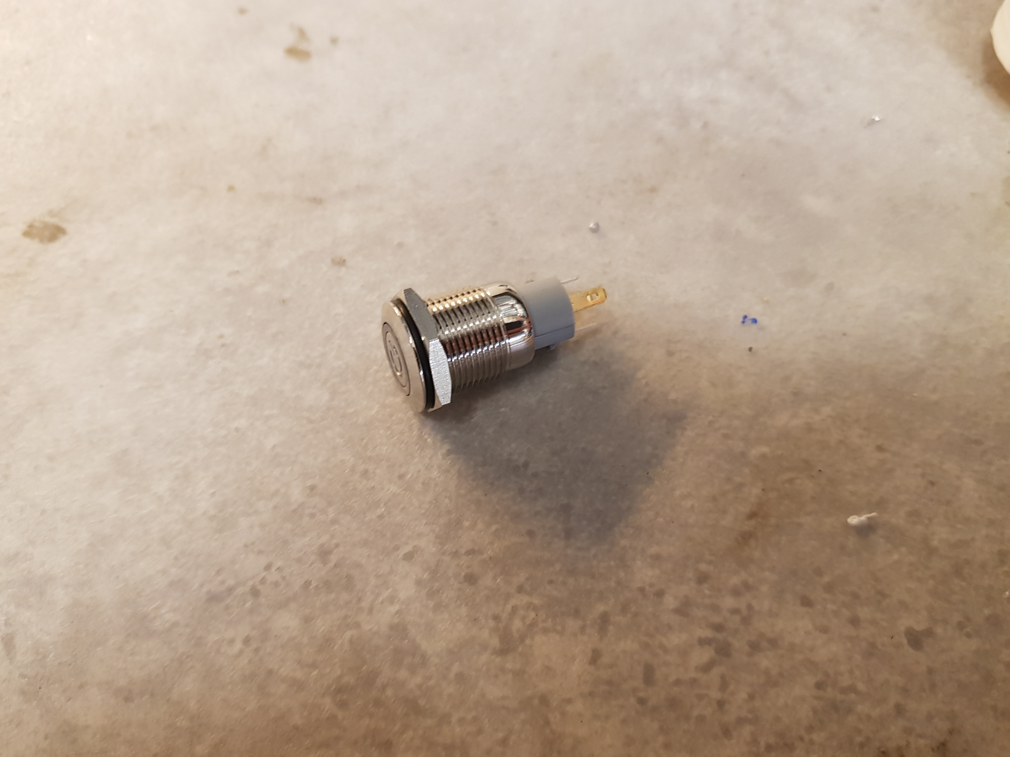
Construction/20190818_185132.jpg
