aboavobr/ABOAVOBR/Construction/20190818_185136.jpg

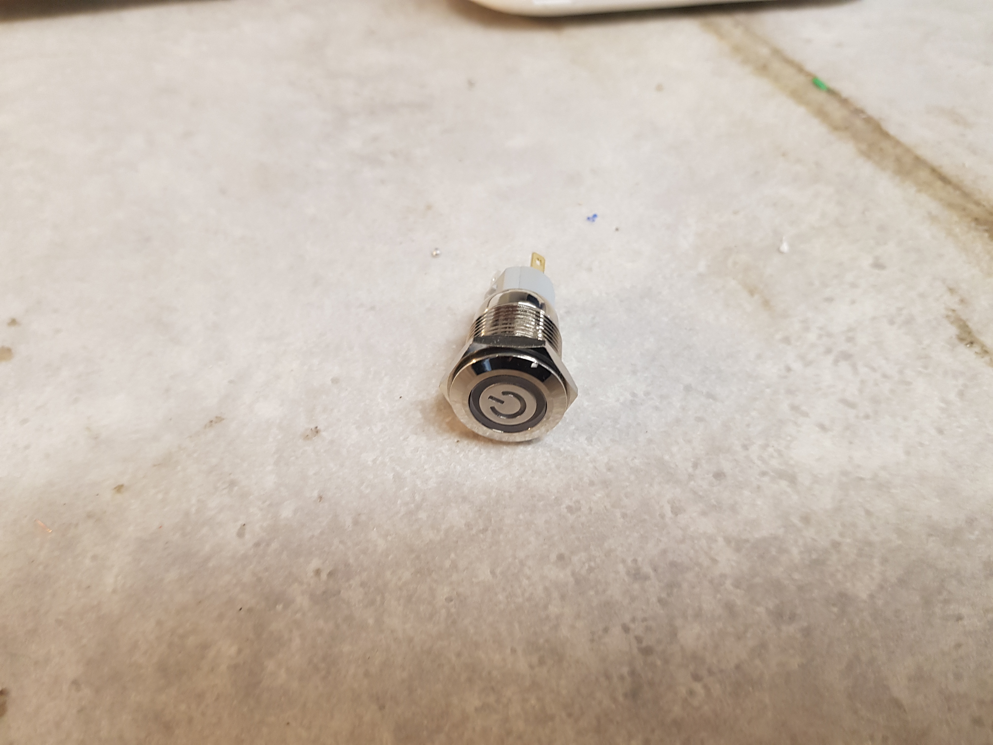
Construction/20190818_185136.jpg
