aboavobr/ABOAVOBR/Construction/20190818_185505.jpg

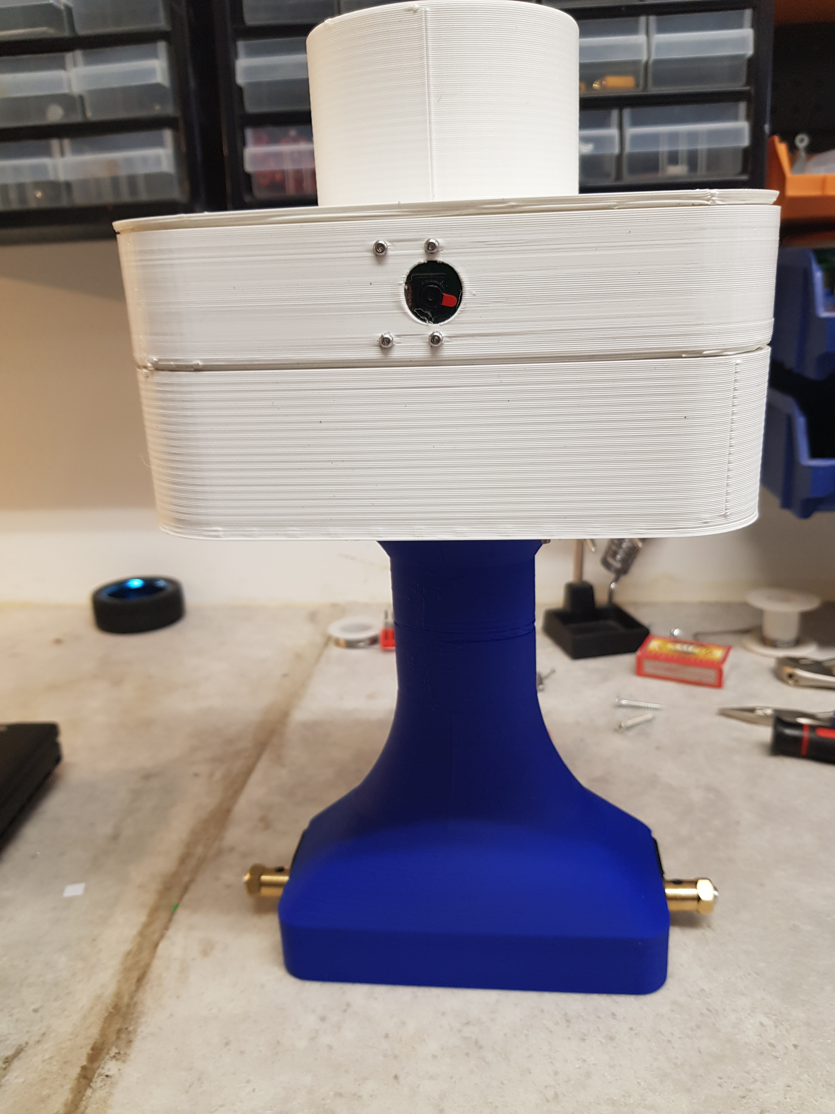
Construction/20190818_185505.jpg
