aboavobr/ABOAVOBR/Construction/20190818_185508.jpg

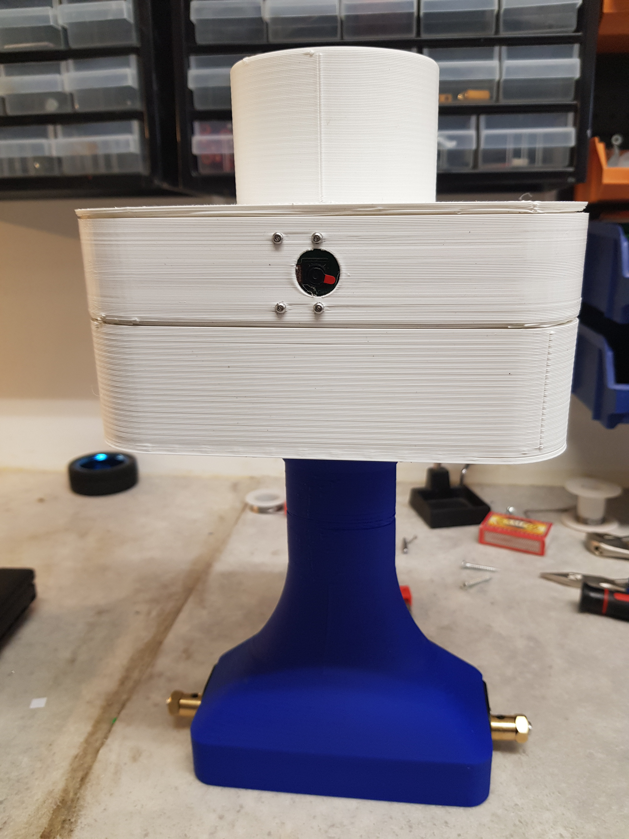
Construction/20190818_185508.jpg
