aboavobr/ABOAVOBR/Construction/20191209_201310.jpg

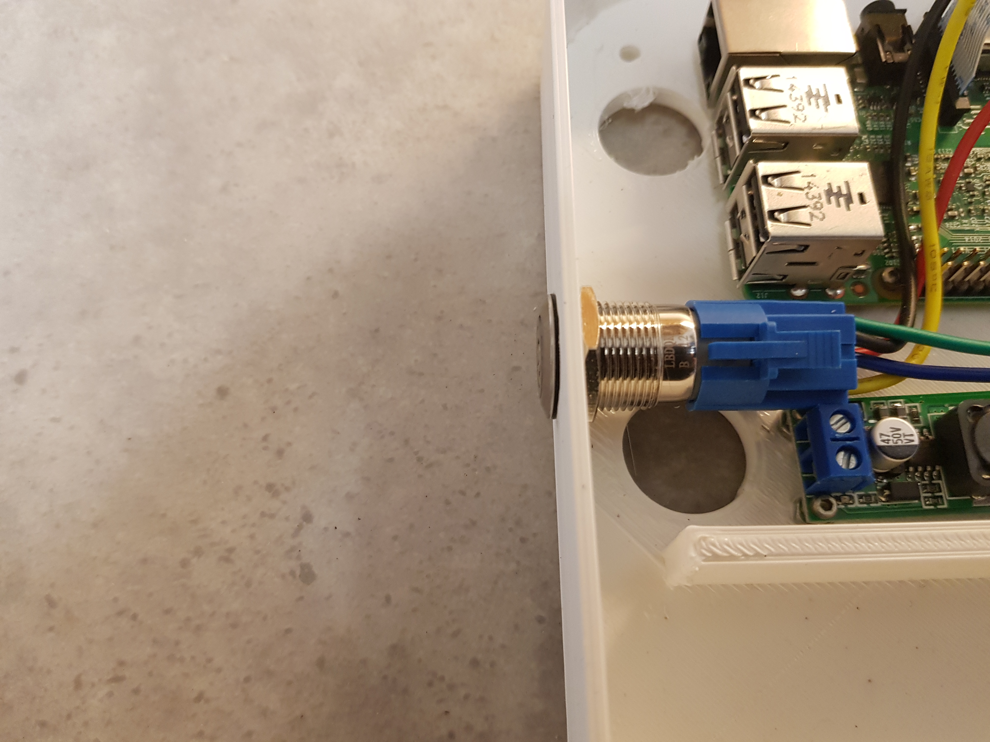
Construction/20191209_201310.jpg
