aboavobr/ABOAVOBR/Construction/20191211_201556.jpg

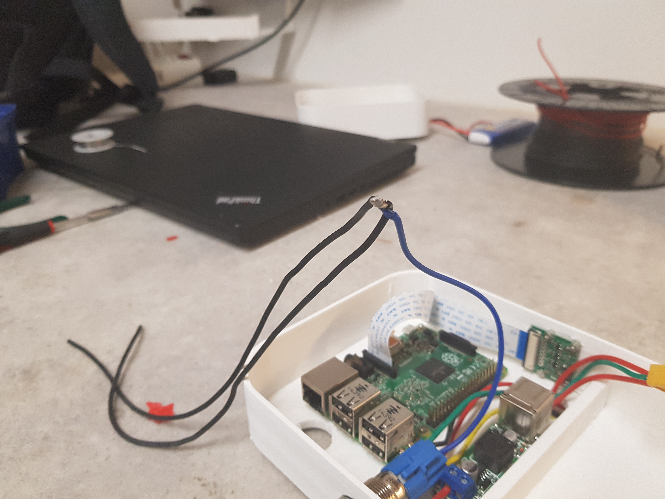
Construction/20191211_201556.jpg
