aboavobr/ABOAVOBR/Construction/20191211_203142.jpg

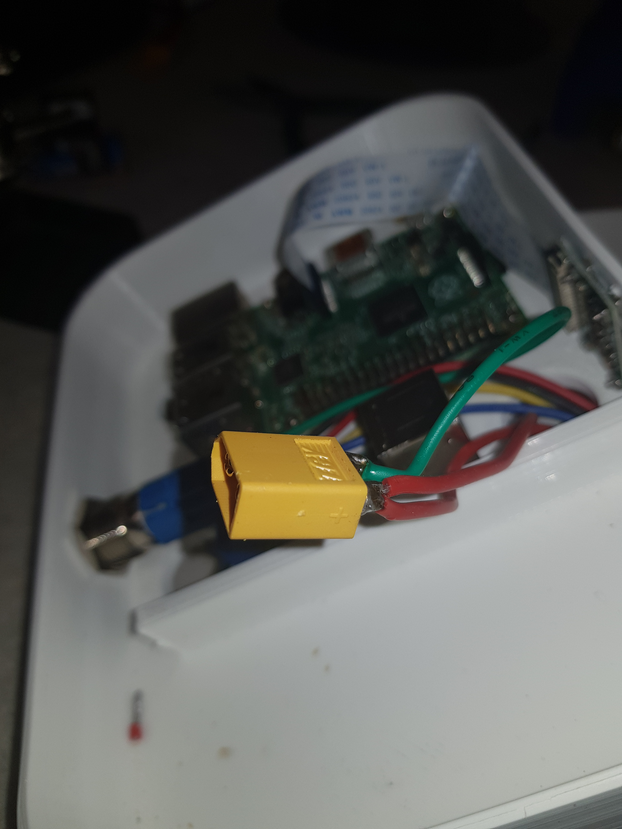
Construction/20191211_203142.jpg
