aboavobr/ABOAVOBR/Construction/20191211_203227.jpg

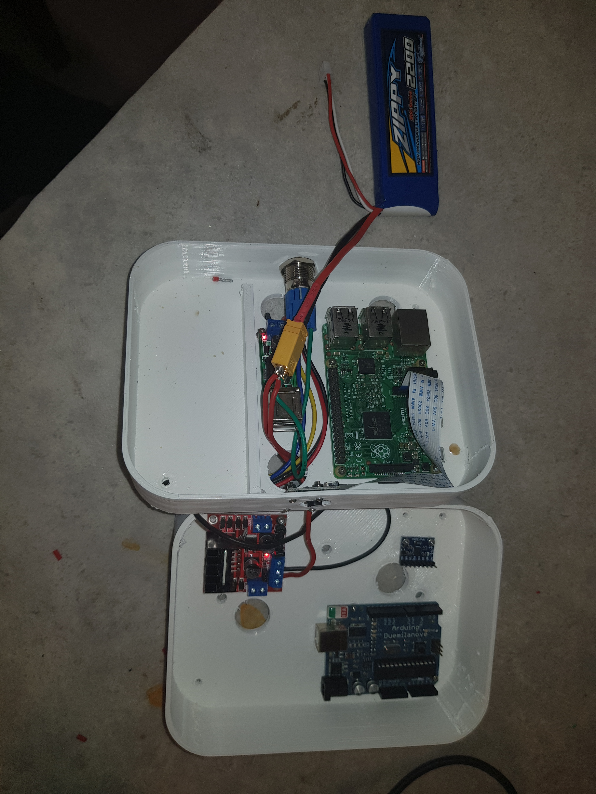
Construction/20191211_203227.jpg
