aboavobr/ABOAVOBR/(threads)

Thread 5 (2019-02-24):

Make Arduino Dockerinstance work on Raspberry Pi

huserben, 2019-02-24:
Currently the automaigc upload of the arduino sketch doesn't work when executed on a RPI.
Update documentation accordingly

huserben, 2019-03-04:
Should work now, needs some more description in the readme before it can be closed

huserben, 2019-03-04:
@klillas Shall we close this one? Or should we have more functionality/documentation?

Closed 2019-03-05.

Thread 7 (2019-03-10):

Connect Battery Charge Reader to Arduino

huserben, 2019-03-10:
Define Interface how to read from RPI
Display Status in Phone App

huserben, 2019-03-15:
Phone and WebApp part done in #10
