aboavobr/ABOAVOBR/(list of files, drawings)

Other design files:
schematics/ABOAVOBR_schematic.fzz
