aboavobr/ABOAVOBR/Arduino/sketch_aboavobr/MotorController.h

/*
  MotorController.h - library for interfacing to the motors of the robot.
*/

#ifndef MotorController_h_
#define MotorController_h_

#include "Arduino.h"

class MotorController
{
  public:
    enum Direction
    {
      Forward = 0,
      Backward = 1
    };

  
    MotorController(byte enablePin, byte in1, byte in2);
    void SetPwm(byte pwm);
    byte GetPwm();
    void SetDirection(Direction newDirection);
    
  private:
    byte enablePin, in1, in2;
    byte pwmOutput;
    Direction direction;
};

#endif
