aboavobr/ABOAVOBR/(commit log)

2019-02-19 Add Arduino Project
2019-02-19 Add scripts to build/upload with strm/dev-arduino docker container
2019-02-19 Add separate BOM to documents
2019-02-20 Add Build Badge for Arduino Build
2019-02-20 Add Arduino Dev Environment Readme
2019-02-20 Adds Dockerfile for aboavobr-arduino container
2019-02-21 Add raspberry pi aspnet core project
2019-02-21 Add Debug controller, remove sample code
2019-02-23 Renamed aboavobr-raspberrypi to aboavobr.raspberrypi
2019-02-23 Update Dockerfile with Raspberry Pi supported base image
2019-02-27 Update Arduino SDE
2019-02-27 Add Raspberry WebApp description
2019-02-28 Add sample xamarin project
2019-02-28 Adjust arduino dockerfile to be based on arm64v8/debian
2019-03-03 Add AutoFac as DI Framework
2019-03-03 Modify the arduino main.sh file to actually WORK
2019-03-04 Adds Arduino Build Env as own docker container
2019-03-04 Update Arduino Readme with docker command
2019-03-05 Adds Toggle Button to Phone App Control Page to send data to Arduino
2019-03-06 Add Settings Button to StartPage
2019-03-07 First theoretically working version of arduino with gyroscope sensor readout
2019-03-11 Add BatteryLife query
2019-03-13 Adds Pitch PID controller to arduino
2019-03-14 Format communicationservice and introduce constants for fetching battery life
2019-03-14 Add CameraController and StreamingService for RaspberryPi
2019-03-15 Add raspberry env image that includes necessary dll's to access camera module
2019-03-15 Base raspberry image on raspberry-env
2019-03-15 Add BatteryState to top bar of control page
2019-03-15 Creates initial Arduino MotorController logic
2019-03-16 Connects PID controller to motors
2019-03-16 Moves Direction to live under MotorController
2019-03-17 Introduce fake streaming service for testing without having actual camera
2019-03-17 Check if camera is supported before using preview image in phone app
2019-03-17 Introduce disposable viewmodel to properly handle timers
2019-03-20 Add control buttons to send move commands to Web App
2019-03-25 Adds first working PID controller to Arduino sketch
    Adds communication protocol for sending commands to Arduino
2019-03-30 Adds download of more recent arduino IDE to arduino build env
2019-04-11 Use arduino-cli for build and upload
2019-04-13 Streamline Arduino-BuildEnv dockerfile
2019-04-13 Update Arduino Dockercontainer for usage with new base image
2019-12-15 Add schematics and assembly pictures
    [ABOAVOBR_schematic.fzz]
