aboavobr/ABOAVOBR/Construction/20190818_163025.jpg

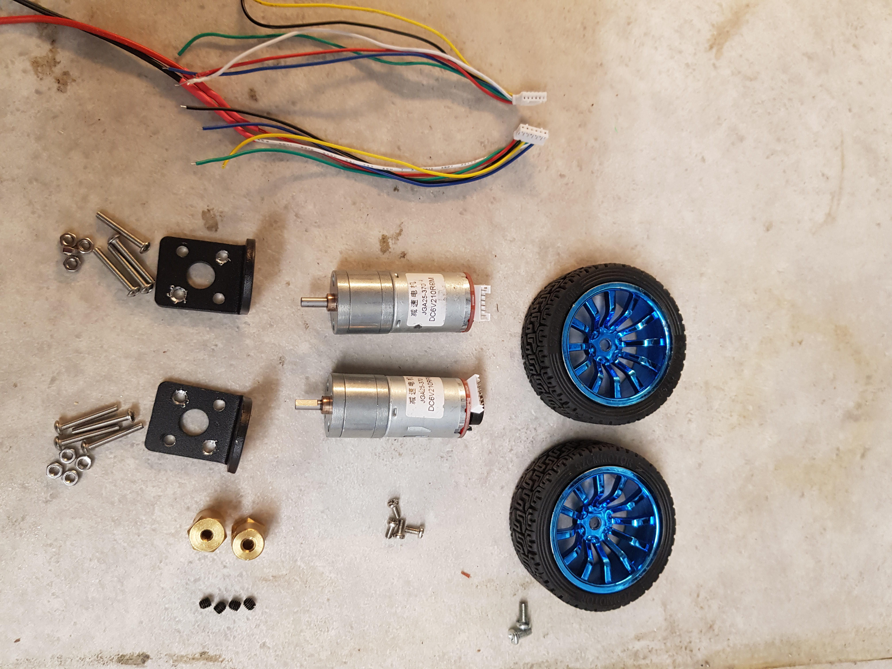
Construction/20190818_163025.jpg
