aboavobr/ABOAVOBR/Construction/20191211_205843.jpg

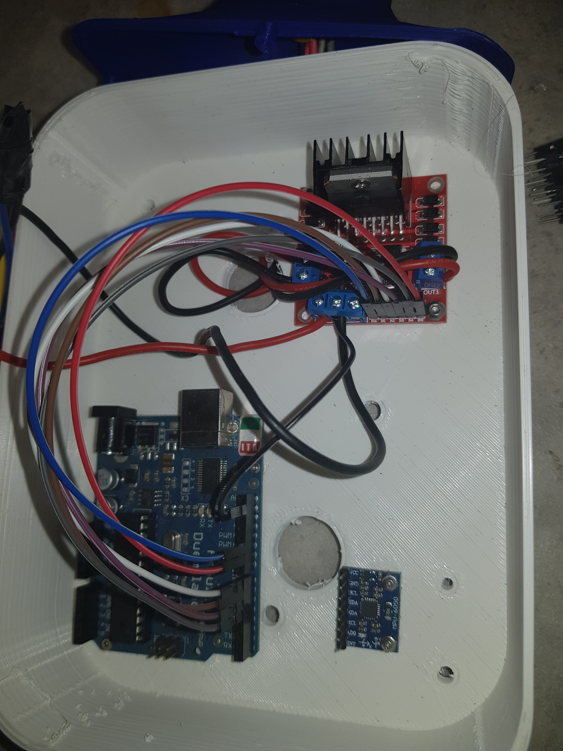
[picture p42: Construction/20191211_205843.jpg]
Construction/20191211_205843.jpg
