aboavobr/ABOAVOBR/Construction/20191211_210627.jpg

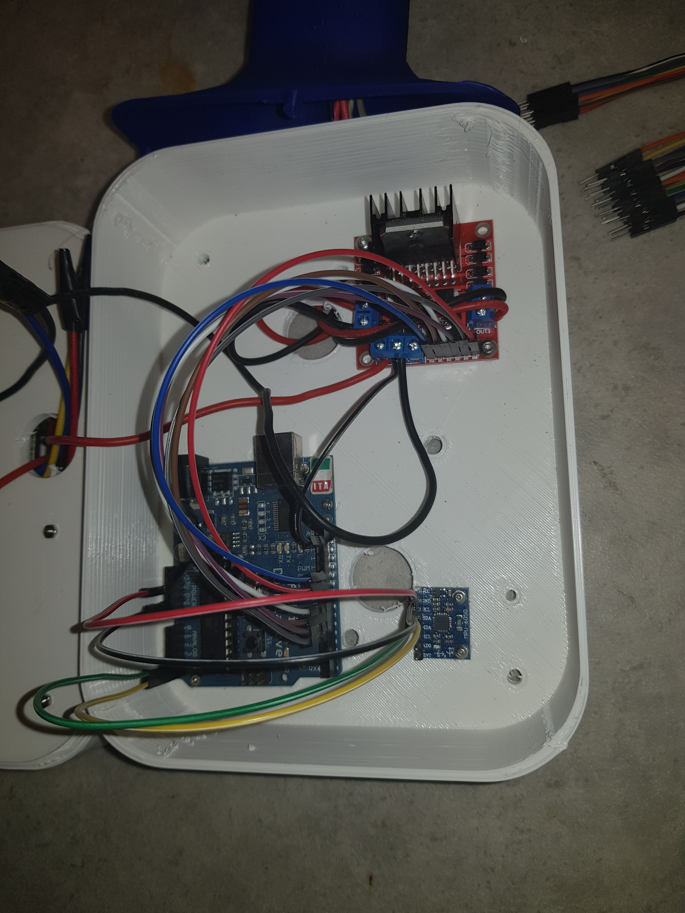
[picture p43: Construction/20191211_210627.jpg]
Construction/20191211_210627.jpg
